crgonzalez/LaserCeeNC/README.md

# LaserCeeNC
Team 8 Senior Thesis Project code

Prototype Version 1 - Completed as of 2/10/16
