crgonzalez/LaserCeeNC/ChristiansEagleLibs/CC3200libs_alikian/Antenna.png

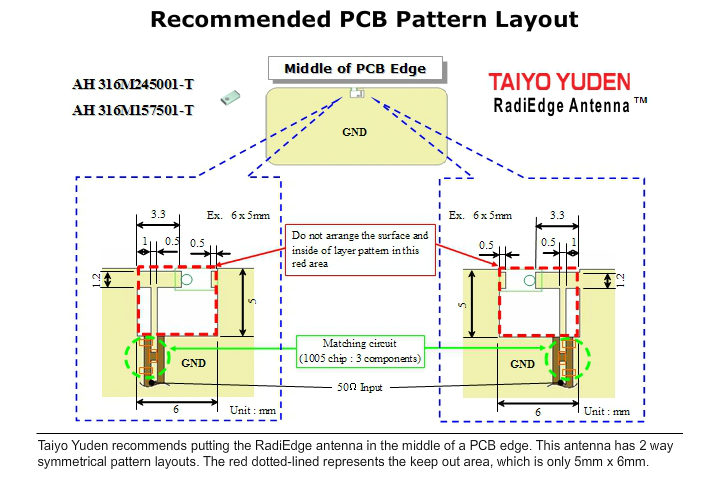
ChristiansEagleLibs/CC3200libs_alikian/Antenna.png
