crgonzalez/LaserCeeNC/ChristiansEagleLibs/CC3200libs_alikian/CC3200MOD_footprint.png

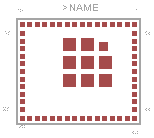
ChristiansEagleLibs/CC3200libs_alikian/CC3200MOD_footprint.png
