crgonzalez/LaserCeeNC/BOMs/LaserBoardBOM.xlsx

Reference | Digikey # | Description | Quantity | Unit Price | Extended Price
U$1 | 945-1610-5-ND | CONV DC/DC 1.5A 6.5-18VIN 5V | 1 | 10.73000 | $10.73
U$2 | 568-5461-1-ND | TXRX XLATING DUAL 3ST 6TSSOP | 1 | 0.45000 | $2.25
U$3, U$4 | 478-8115-1-ND | CAP TANT 10UF 6.3V 20% 0805 | 2 | 0.37000 | $0.74
U$5 | 360-2029-ND | SWITCH PUSHBUTTON SPDT 3A 125V | 1 | 13.85000 | $13.85
U$6 | 36-3527-ND | FUSE BLOCK CART 250V 6.3A PCB | 1 | 1.31000 | $1.31
U$7 | 296-2563-5-ND | IC 2.2A POWER DIST SWITCH 8-SOIC | 1 | 2.82000 | $2.82
U$8 | 609-3210-ND | CONN HEADER 6POS .100 STR 15AU | 1 | 0.40000 | $0.40
U$9 | 360-2188-ND | SENSOR TILT SW 30-60DEG 20MA TH | 1 | 6.39000 | $6.39
R1 | P510ADCT-ND | RES SMD 510 OHM 5% 1/2W 0805 | 1 | 0.12000 | $0.12
R2 | RMCF0805JT10K0CT-ND | RES SMD 10K OHM 5% 1/8W 0805 | 1 | 0.10000 | $0.10
R5 | 311-200ARCT-ND | RES SMD 200 OHM 5% 1/8W 0805 | 1 | 0.10000 | $0.10
R6 | 311-100KCRCT-ND | RES SMD 100K OHM 1% 1/8W 0805 | 1 | 0.10000 | $0.10
C1 | 478-1402-1-ND | CAP CER 0.33UF 16V X7R 0805 | 1 | 0.24000 | $0.24
C2 | 1276-1007-1-ND | CAP CER 0.1UF 50V Y5V 0805 | 1 | 0.10000 | $0.10
C3 | 1276-2412-1-ND | CAP CER 22UF 6.3V X5R 0805 | 1 | 0.25000 | $0.25
12V-PWR | CP-002AHPJCT-ND | CONN POWER JACK 2.1X5.5MM HI CUR | 1 | 1.89000 | $1.89
LSR_CONN, FAN_CONN | 455-2247-ND | CONN HEADER XH TOP 2POS 2.5MM | 2 | 0.15000 | $0.30
3.3V-REG | LMS8117AMP-3.3/NOPBCT-ND | IC REG LDO 3.3V 1A SOT223 | 1 | 1.11000 | $1.11
FUSE | 507-1253-ND | FUSE GLASS 5A 250VAC 5X20MM | 1 | 0.22000 | $0.44
