crgonzalez/LaserCeeNC/BOMs/MotorBoardBOM.xlsx

Reference | Digikey # | Description | Quantity | Unit Price | Extended Price
X_JST, Y_JST | 455-2243-ND | CONN HEADER XH SIDE 4POS 2.5MM | 2 | 0.27000 | $0.54
X_C10, Y_C10 | 399-3685-1-ND | CAP TANT 10UF 6.3V 20% 1206 | 2 | 0.35000 | $0.70
X_C8, Y_C8 | 399-3700-1-ND | CAP TANT 47UF 6.3V 20% 1206 | 2 | 0.73000 | $1.46
X_L6472, Y_L6472 | 497-14657-ND | IC MOTOR DRIVER SPI 36POWERSO | 2 | 7.69000 | $15.38
X_C5, Y_C5 | 399-1251-1-ND | CAP CER 0.22UF 50V X7R 1206 | 2 | 0.19000 | $0.38
X_C6, Y_C6 | 311-1174-1-ND | CAP CER 10000PF 50V X7R 1206 | 2 | 0.14000 | $0.28
X_BAV99, Y_BAV99 | 568-1625-1-ND | DIODE ARRAY GP 100V 150MA SOT323 | 2 | 0.21000 | $0.42
X_C1-X_C4, X_C7, X_C9, Y_C1-Y_C4, Y_C7, Y_C9 | 399-1249-1-ND | CAP CER 0.1UF 50V X7R 1206 | 12 | 0.07200 | $0.86
R1-R5 | CRS1206-FX-1002ELFCT-ND | RES SMD 10K OHM 1% 1/2W 1206 | 5 | 0.44000 | $2.20
X_BAC, Y_BAC | PCE3867CT-ND | CAP ALUM 100UF 20% 10V SMD | 2 | 0.43000 | $0.86
HEADER | A106656-ND | CONN RCPT VERT HV-100 6POS | 2 | 0.87000 | $1.74
