crgonzalez/LaserCeeNC/BOMs/OtherBOM.xlsx

Reference | Digikey # | Description | Quantity | Unit Price | Extended Price
StandOffs | 36-25501-ND | HEX STANDOFF M3 NYLON 10MM | 12 | 0.41200 | $4.95
Screws | 36-29341-ND | MACHINE SCREW PAN SLOTTED M3 | 4 | 0.20000 | $0.80
Hex Nut | 36-4688-ND | HEX NUT 0.217" NYLON M3 | 4 | 0.14000 | $0.56
