crgonzalez/LaserCeeNC/BOMs/uCBoardBOM.xlsx

Reference | Digikey # | Description | Quantity | Unit Price | Extended Price
U$1 | 296-42325-1-ND | IC MCU SIMPLELINK WI-FI MOD VQFN | 1 | 25.98 | $25.98
U$2 | 587-2200-1-ND | ANT BLUETOOTH W-LAN ZIGBEE WIMAX | 1 | 1.95 | $1.95
U$3 | P8070SCT-ND | SWITCH TACTILE SPST-NO 0.02A 15V | 1 | 0.29 | $0.29
U$4 | 5176837-4-SI-ND | CONN HDR BRKWAY 10POS R/A GOLD | 1 | 0.89 | $0.89
U$5, U$7 | A106656-ND | CONN RCPT VERT HV-100 6POS | 2 | 0.87 | $1.74
U$6 | 609-3210-ND | CONN HEADER 6POS .100 STR 15AU | 2 | 0.4 | $0.80
U$8 | A118117CT-ND | MICRO SD PUSH PUSH LOW PROFILE T | 1 | 4.28 | $4.28
C1 | 1276-3375-1-ND | CAP CER 220UF 6.3V X5R 1210 | 1 | 1.65 | $1.65
C2 | 1276-1766-1-ND | CAP CER 1PF 50V NP0 0805 | 1 | 0.1 | $0.10
C3 | 490-3340-1-ND | CAP CER 10UF 6.3V X5R 0805 | 2 | 0.15 | $0.30
R1 | RMCF0805JT2K70CT-ND | RES SMD 2.7K OHM 5% 1/8W 0805 | 1 | 0.1 | $0.10
R6 | 311-100CRCT-ND | RES SMD 100 OHM 1% 1/8W 0805 | 1 | 0.1 | $0.10
X1 | A122805-ND | CONN RCPT 4POS VERT T/H GOLD | 1 | 0.61 | $0.61
L1 | 490-6756-1-ND | FIXED IND 3.6NH 170MA 500 MOHM | 1 | 0.18 | $0.18
R2-R5 | 311-100KCRCT-ND | RES SMD 100K OHM 1% 1/8W 0805 | 4 | 0.021 | $0.21
