crgonzalez/LaserCeeNC/(list of files, cad)

Other CAD files:
Software/LaserCeenC/Release/optimizerAssistant/opt_for_speed__3/main.obj
Software/LaserCeenC/Release/optimizerAssistant/opt_for_speed__1/main.obj
Software/LaserCeenC/Release/optimizerAssistant/opt_for_speed__2/main.obj
Software/LaserCeenC/Release/optimizerAssistant/opt_for_speed__4/main.obj
Software/LaserCeenC/Release/optimizerAssistant/opt_for_speed__0/main.obj
Software/LaserCeenC/Release/optimizerAssistant/opt_for_speed__0/startup_ccs.obj
Software/LaserCeenC/Release/optimizerAssistant/opt_for_speed__1/smartconfig.obj
Software/LaserCeenC/Release/optimizerAssistant/opt_for_speed__2/gpio_if.obj
Software/LaserCeenC/Release/optimizerAssistant/opt_for_speed__4/gpio_if.obj
Software/LaserCeenC/Release/optimizerAssistant/opt_for_speed__0/uart_if.obj
Software/LaserCeenC/Release/optimizerAssistant/opt_for_speed__3/uart_if.obj
Software/LaserCeenC/Release/optimizerAssistant/opt_for_speed__0/gpio_if.obj
Software/LaserCeenC/Release/optimizerAssistant/opt_for_speed__1/startup_ccs.obj
Software/LaserCeenC/Release/optimizerAssistant/opt_for_speed__2/smartconfig.obj
Software/LaserCeenC/Release/optimizerAssistant/opt_for_speed__3/fileparse.obj
Software/LaserCeenC/Release/optimizerAssistant/opt_for_speed__4/uart_if.obj
Software/LaserCeenC/Release/optimizerAssistant/opt_for_speed__0/fileparse.obj
Software/LaserCeenC/Release/optimizerAssistant/opt_for_speed__1/uart_if.obj
Software/LaserCeenC/Release/optimizerAssistant/opt_for_speed__2/pinmux.obj
Software/LaserCeenC/Release/optimizerAssistant/opt_for_speed__3/gpio_if.obj
Software/LaserCeenC/Release/optimizerAssistant/opt_for_speed__4/pinmux.obj
Software/LaserCeenC/Release/optimizerAssistant/opt_for_speed__0/smartconfig.obj
Software/LaserCeenC/Release/optimizerAssistant/opt_for_speed__1/pinmux.obj
Software/LaserCeenC/Release/optimizerAssistant/opt_for_speed__2/uart_if.obj
Software/LaserCeenC/Release/optimizerAssistant/opt_for_speed__3/smartconfig.obj
Software/LaserCeenC/Release/optimizerAssistant/opt_for_speed__4/fileparse.obj
Software/LaserCeenC/Release/optimizerAssistant/opt_for_speed__1/fileparse.obj
Software/LaserCeenC/Release/optimizerAssistant/opt_for_speed__2/fileparse.obj
Software/LaserCeenC/Release/optimizerAssistant/opt_for_speed__3/startup_ccs.obj
Software/LaserCeenC/Release/optimizerAssistant/opt_for_speed__4/startup_ccs.obj
Software/LaserCeenC/Release/optimizerAssistant/opt_for_speed__0/pinmux.obj
Software/LaserCeenC/Release/optimizerAssistant/opt_for_speed__1/gpio_if.obj
Software/LaserCeenC/Release/optimizerAssistant/opt_for_speed__2/startup_ccs.obj
Software/LaserCeenC/Release/optimizerAssistant/opt_for_speed__3/pinmux.obj
Software/LaserCeenC/Release/optimizerAssistant/opt_for_speed__4/smartconfig.obj
