crgonzalez/LaserCeeNC/BlockDiagram/BlockDiagram.pdf

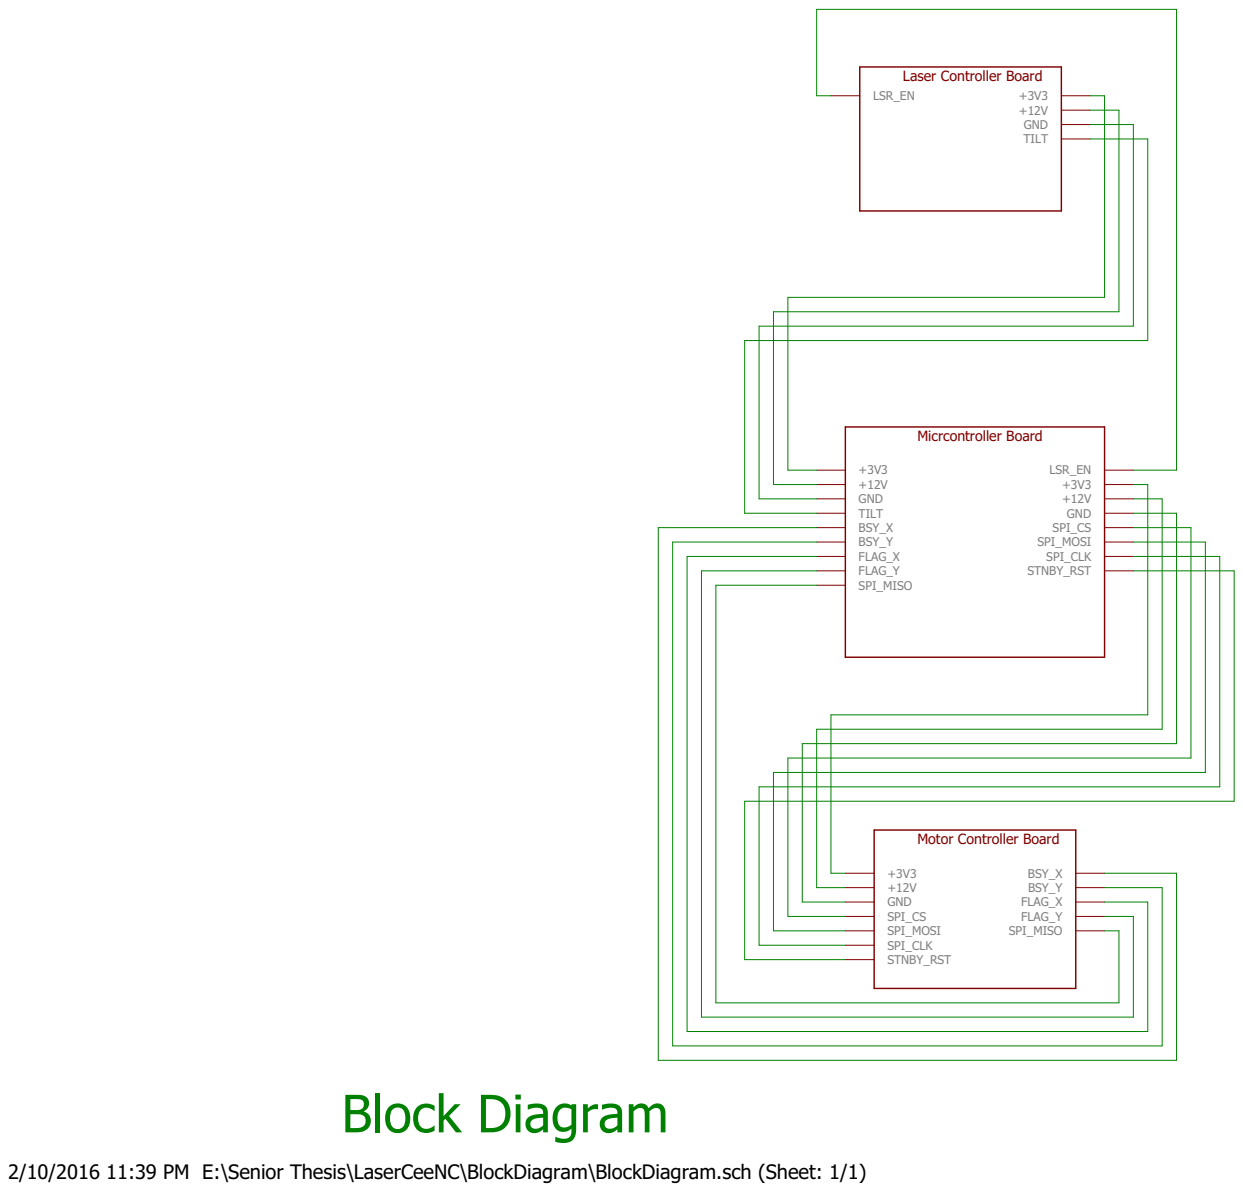
[picture p3: page 1]

2/10/2016 11:39 PM E:\Senior Thesis\LaserCeeNC\BlockDiagram\BlockDiagram.sch (Sheet: 1/1)
