crgonzalez/LaserCeeNC/LaserBoard/laserboard.pdf

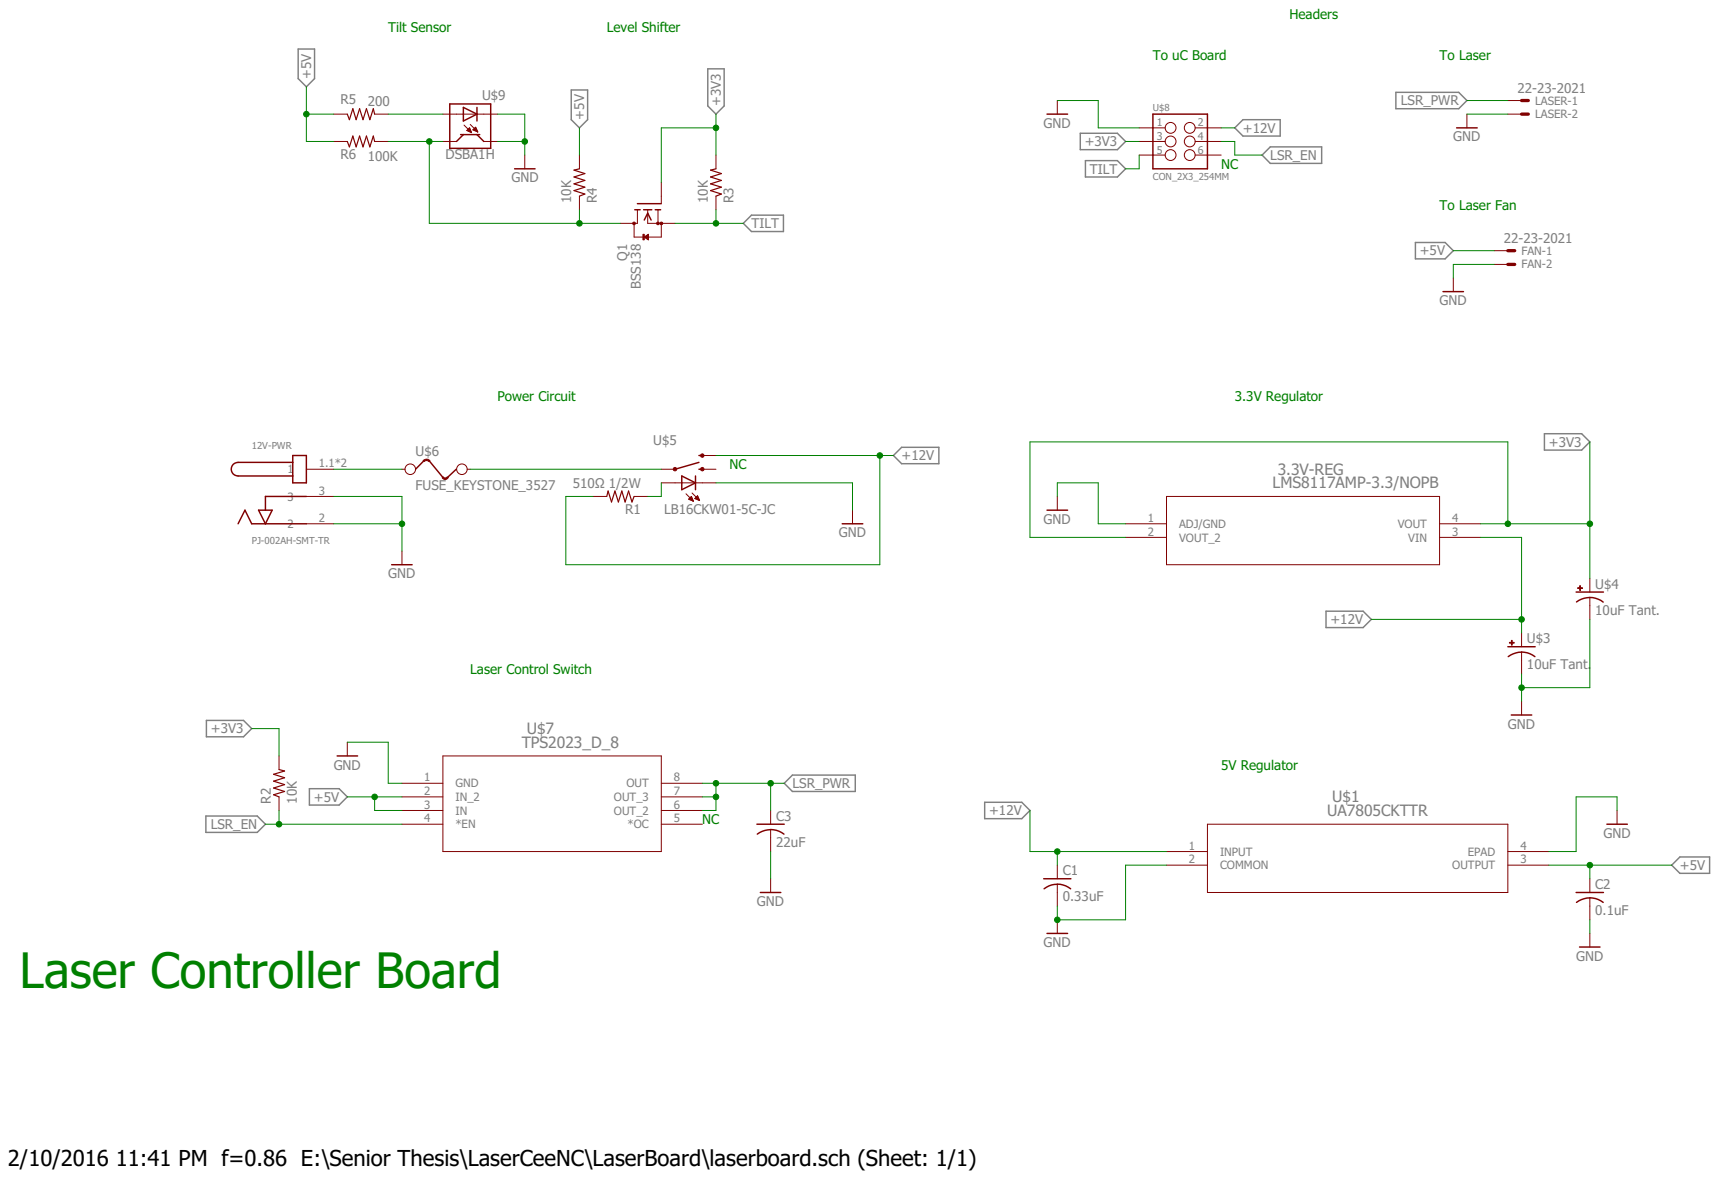
[picture p4: page 1]

2/10/2016 11:41 PM f=0.86 E:\Senior Thesis\LaserCeeNC\LaserBoard\laserboard.sch (Sheet: 1/1)
