crgonzalez/LaserCeeNC/uCBoard/uCBoard.pdf

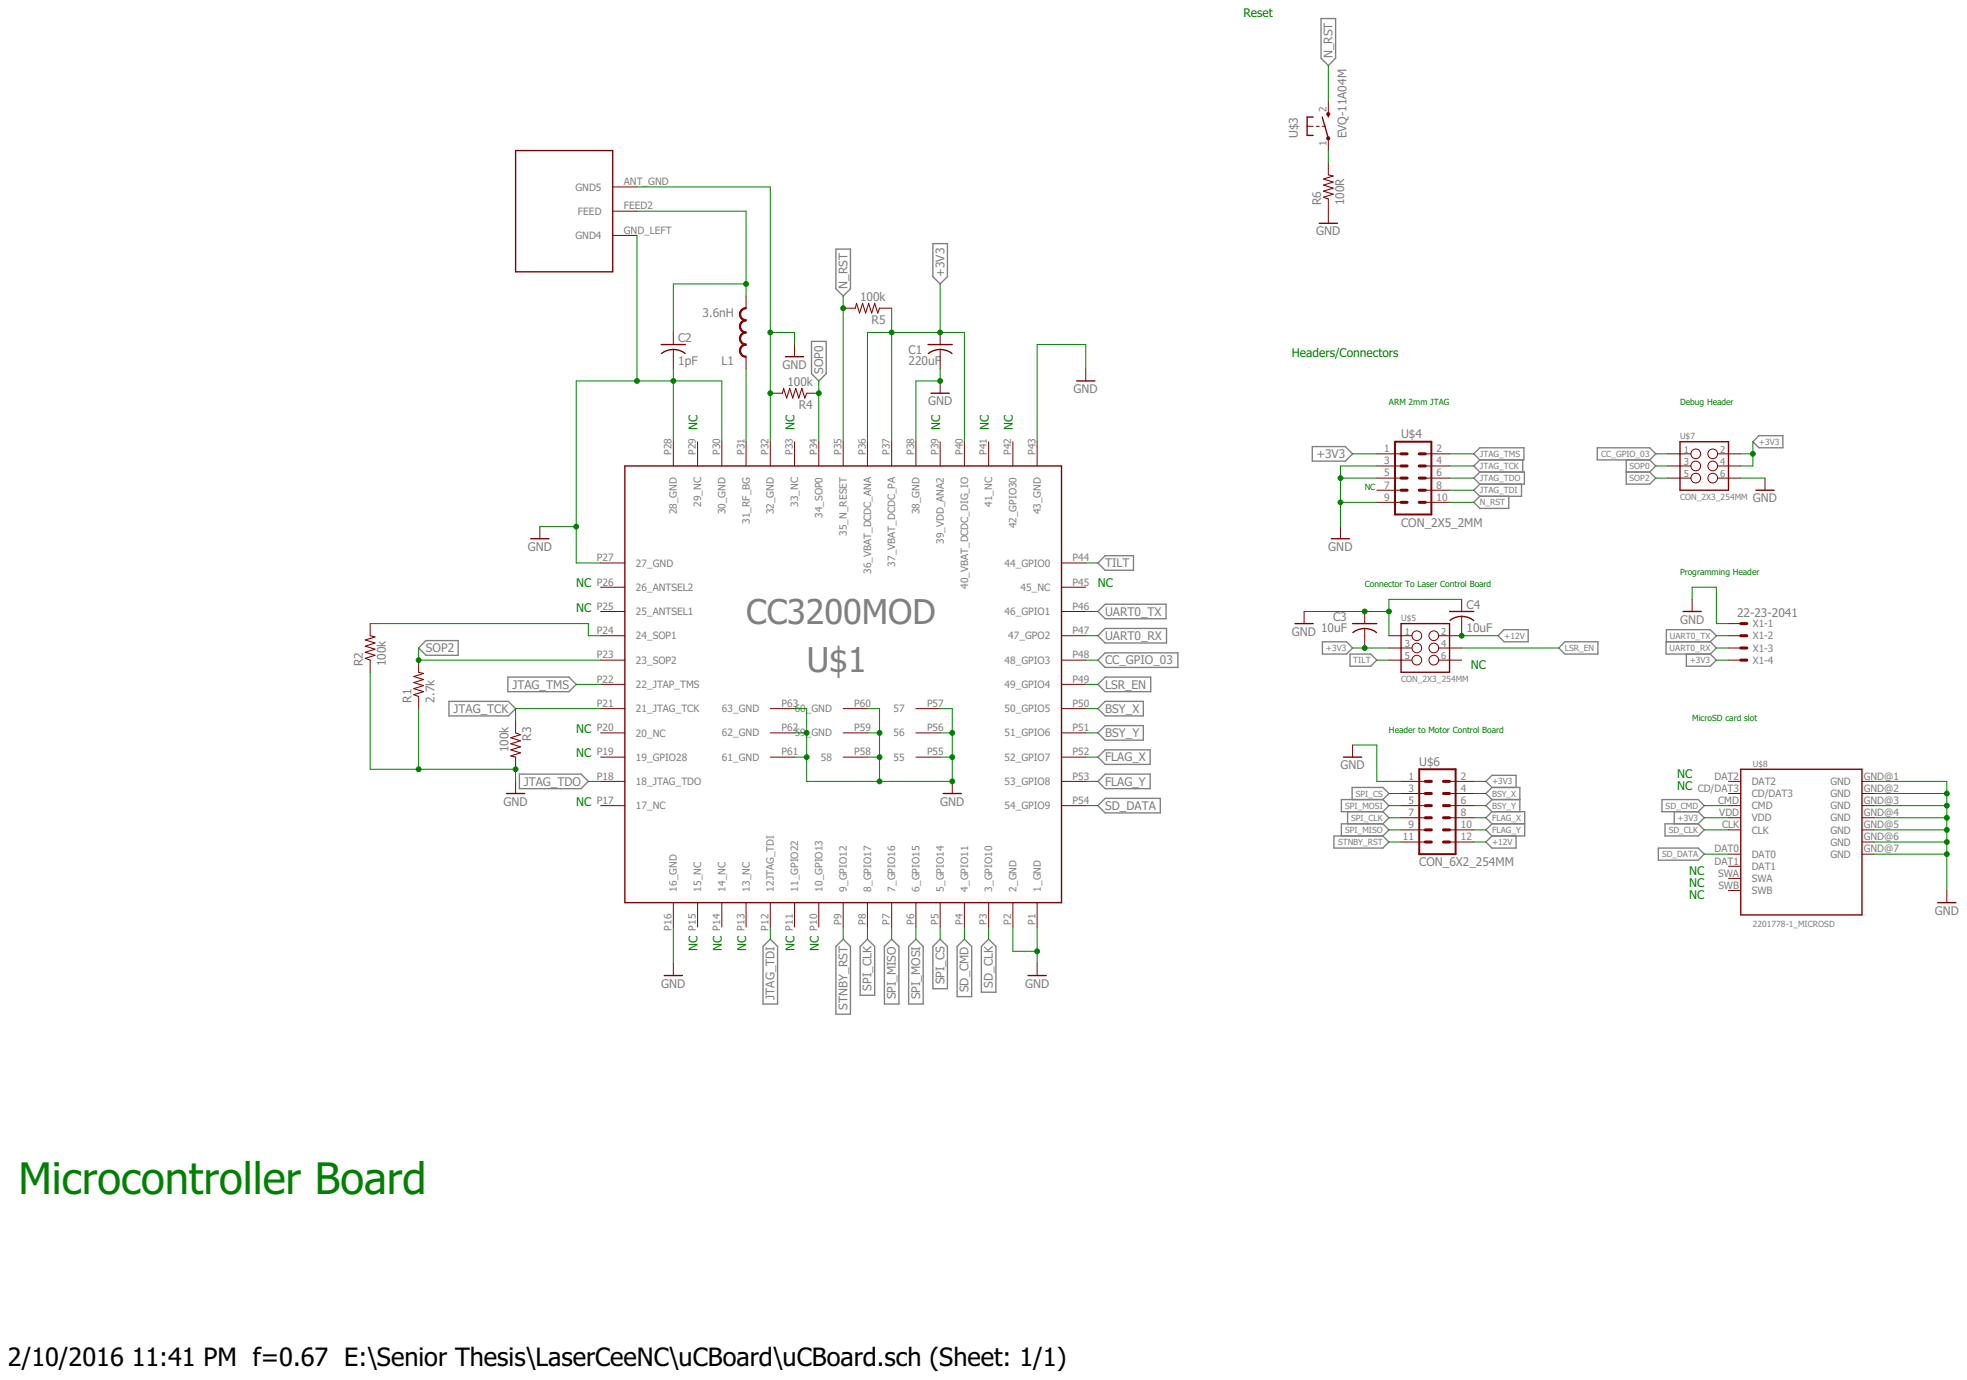
[picture p5: page 1]

Connector To Laser Control Board

Header to Motor Control Board NC

2/10/2016 11:41 PM f=0.67 E:\Senior Thesis\LaserCeeNC\uCBoard\uCBoard.sch (Sheet: 1/1)
