crgonzalez/LaserCeeNC/L6472Board/L6472V1/L6472V1.pdf

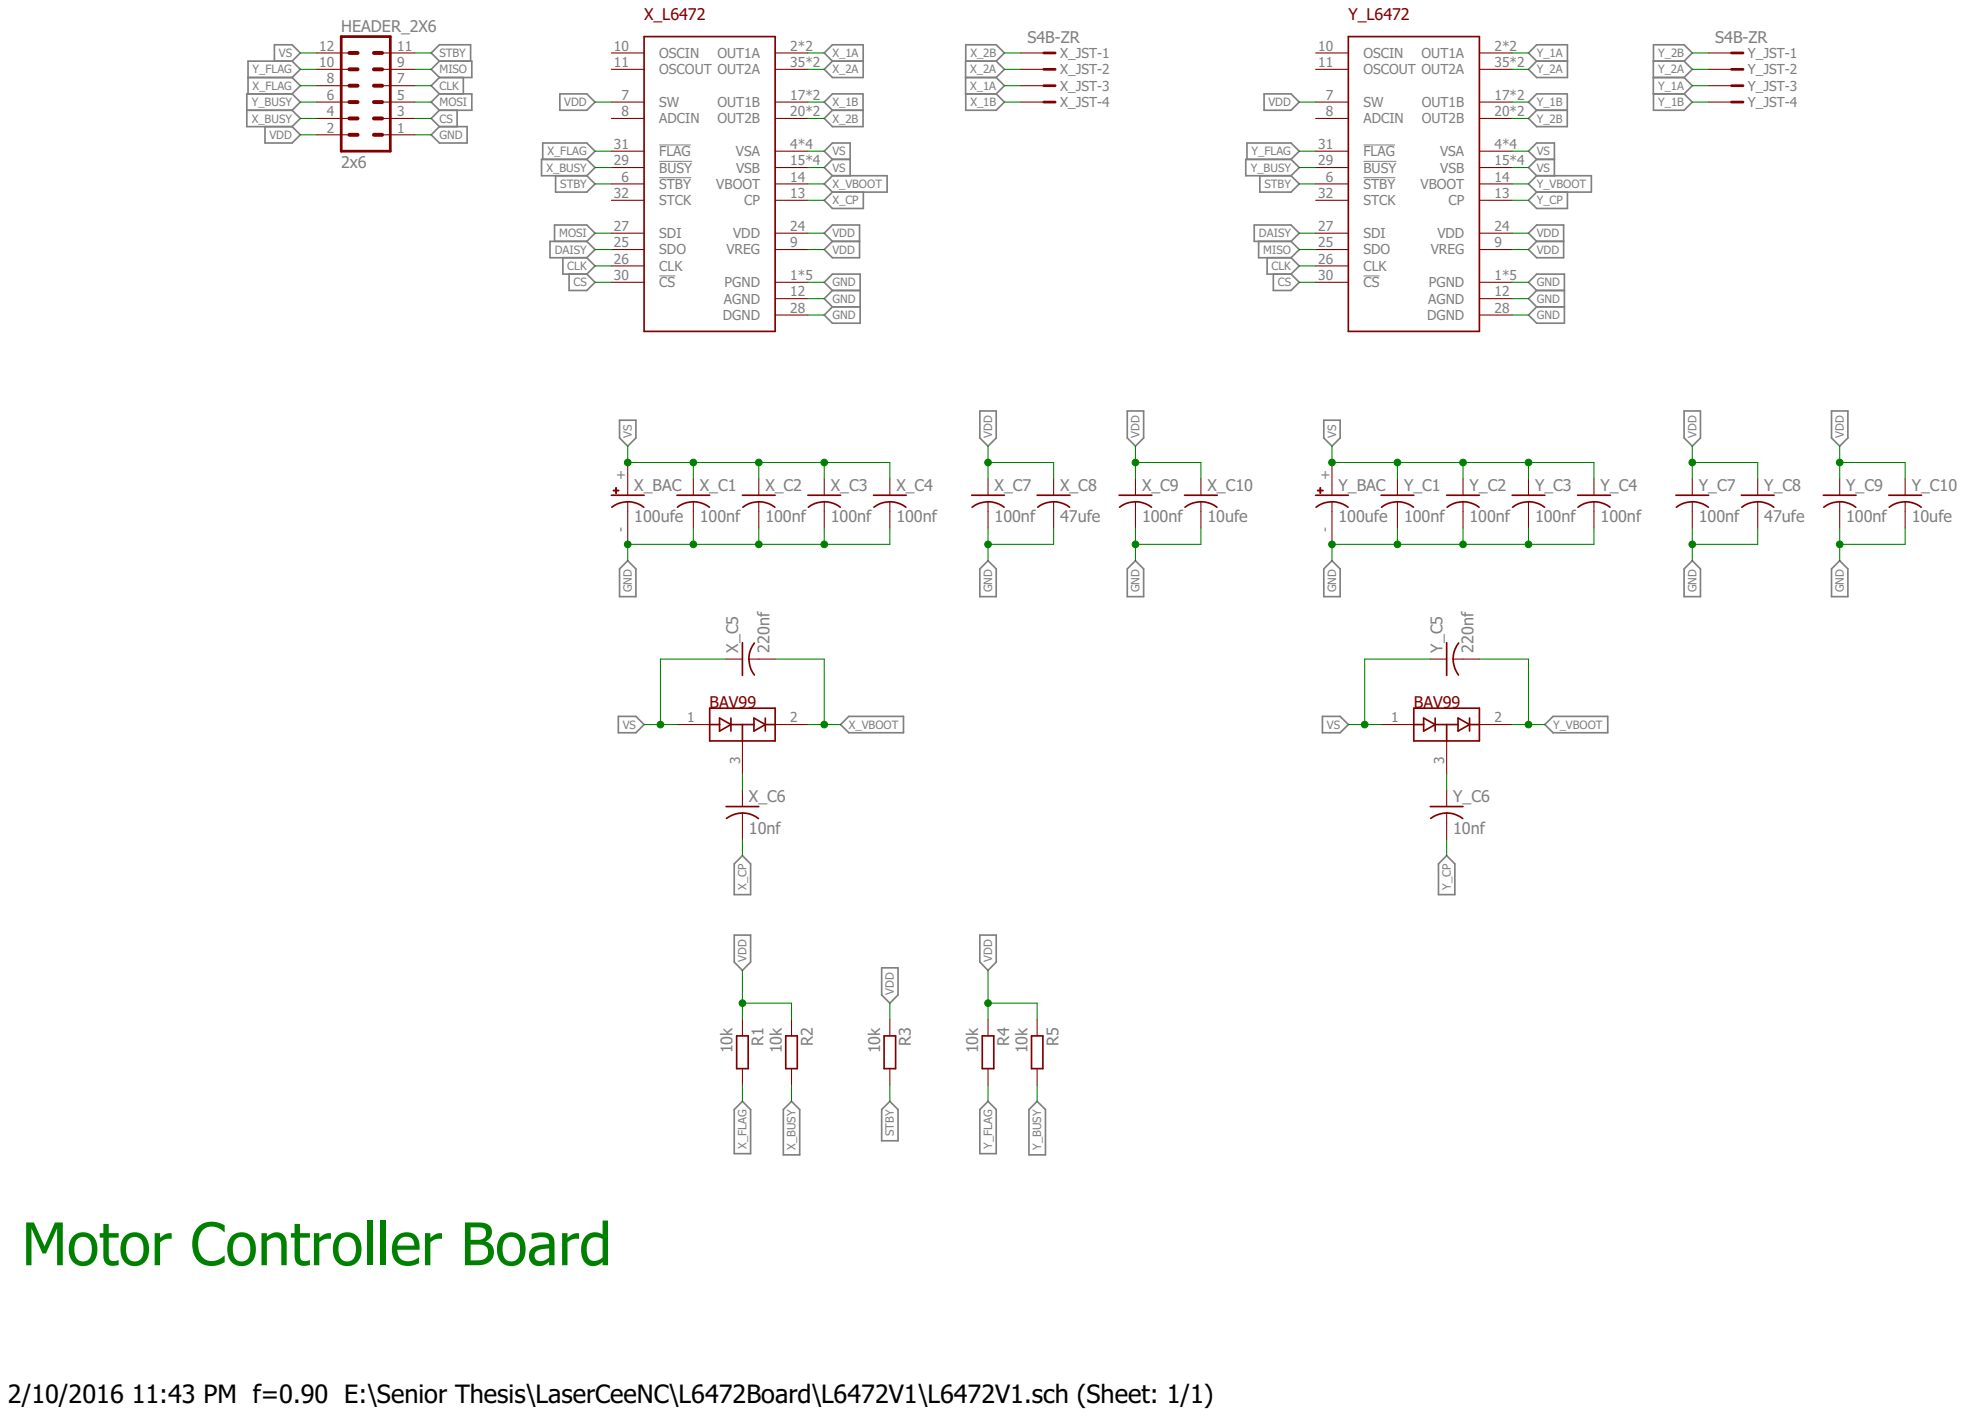
[picture p6: page 1]

2/10/2016 11:43 PM f=0.90 E:\Senior Thesis\LaserCeeNC\L6472Board\L6472V1\L6472V1.sch (Sheet: 1/1)
