crgonzalez/LaserCeeNC/LaserBoard/laserboard.brd

## EAGLE design LaserBoard/laserboard.brd (2016-03-13)

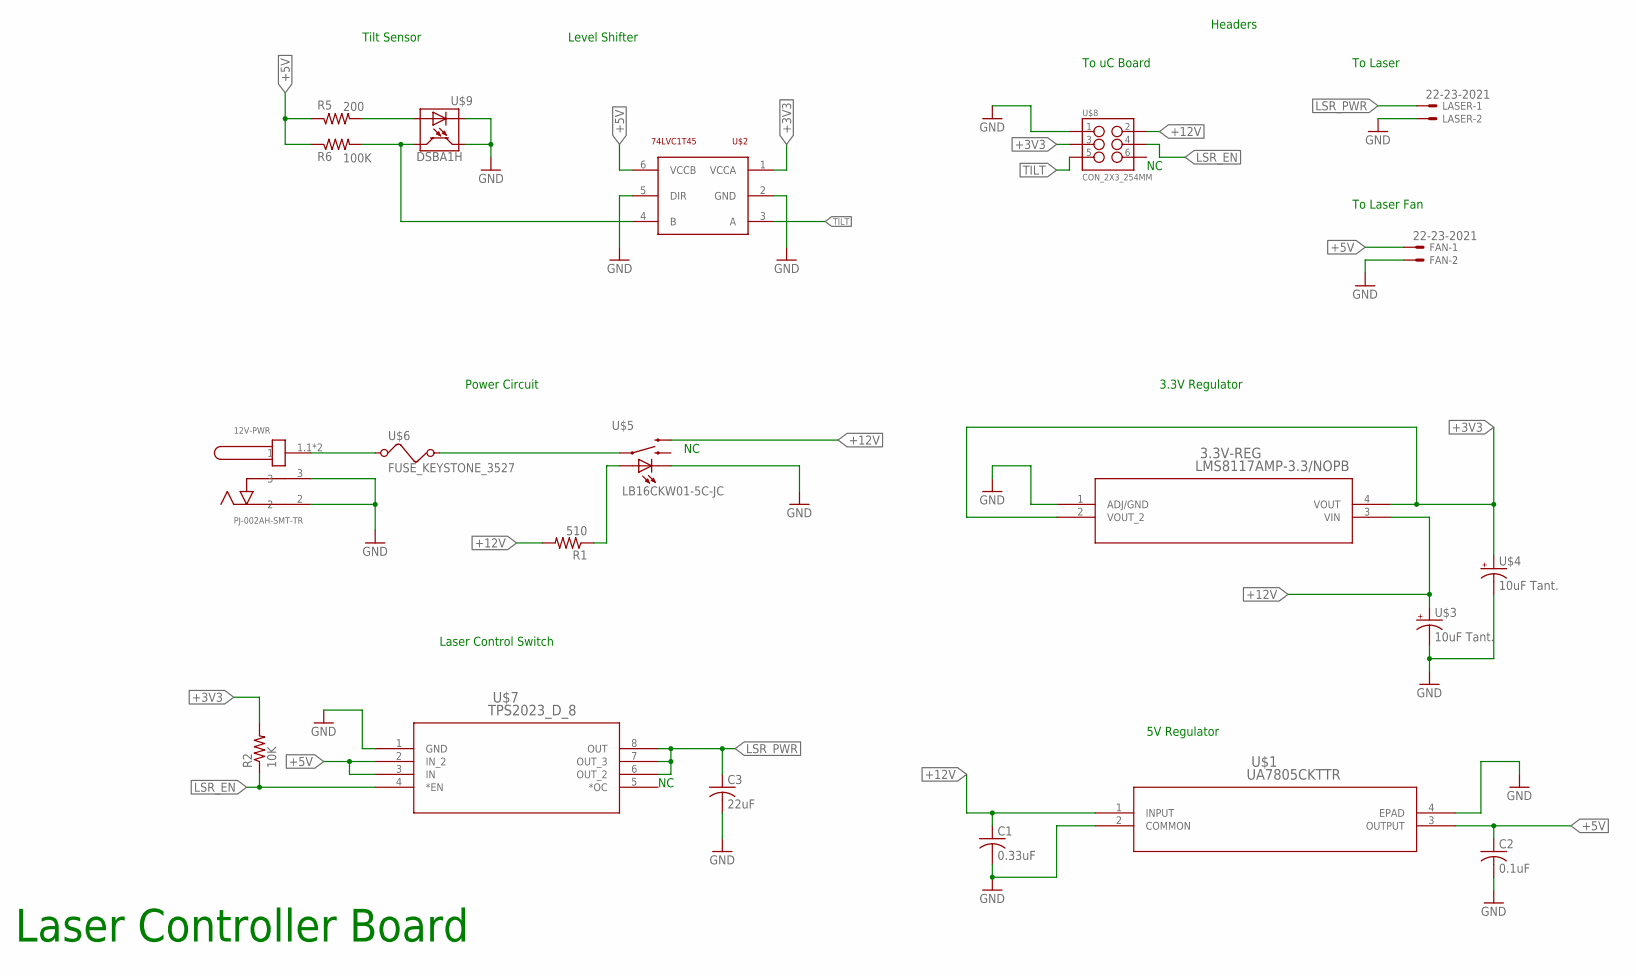
[picture p7: schematic laserboard.sch]

Parts:
3.3V-REG: LMS8117AMP-3.3/NOPB; MP04A
12V-PWR: PJ-002AH-SMT-TR; CUI_PJ-002AH-SMT-TR
C1: 0.33uF; C0805
C2: 0.1uF; C0805
C3: 22uF; C0805
FAN: 22-23-2021
LASER: 22-23-2021
R1: 510; R0805
R2: 10K; R0805
R5: 200; R0805
R6: 100K; R0805
U$1: UA7805CKTTR; KTT3_6P22X6P6
U$2: 74LVC1T45; SOT363
U$3, U$4: 10uF Tant.; C0805
U$5: LB16CKW01-5C-JC
U$6: FUSE_KEYSTONE_3527; KEYSTONE3527
U$7: TPS2023_D_8; D8
U$8: CON_2X3_254MM
U$9: DSBA1H

Connections:
+3V3: 3.3V-REG.2 (VOUT_2), 3.3V-REG.4 (VOUT), R2.2, U$2.1 (VCCA), U$4.+, U$8.3
+5V: C2.1, FAN.1, R5.1, R6.1, U$1.3 (OUTPUT), U$2.6 (VCCB), U$7.2 (IN_2), U$7.3 (IN)
+12V: 3.3V-REG.3 (VIN), C1.1, R1.2, U$1.1 (INPUT), U$3.+, U$5.2, U$8.2
GND: 3.3V-REG.1 (ADJ/GND), 12V-PWR.2, 12V-PWR.3, C1.2, C2.2, C3.2, FAN.2, LASER.2, U$1.2 (COMMON), U$1.4 (EPAD), U$2.2 (GND), U$2.5 (DIR), U$3.-, U$4.-, U$5.-, U$7.1 (GND), U$8.1, U$9.-, U$9.E
LSR_EN: R2.1, U$7.4 (*EN), U$8.4
LSR_PWR: C3.1, LASER.1, U$7.6 (OUT_2), U$7.7 (OUT_3), U$7.8 (OUT)
unnamed: R1.1, U$5.+
unnamed: 12V-PWR.1.1 (1), 12V-PWR.1.2 (1), U$6.P$1 (1)
unnamed: U$5.1, U$6.P$2 (2)
unnamed: R6.2, U$2.4 (B), U$9.C
unnamed: R5.2, U$9.+
TILT: U$2.3 (A), U$8.5

Notes on the sheet:
5V Regulator
3.3V Regulator
Power Circuit
Laser Control Switch
Headers
To Laser
To Laser Fan
To uC Board
Tilt Sensor
Level Shifter
Laser Controller Board

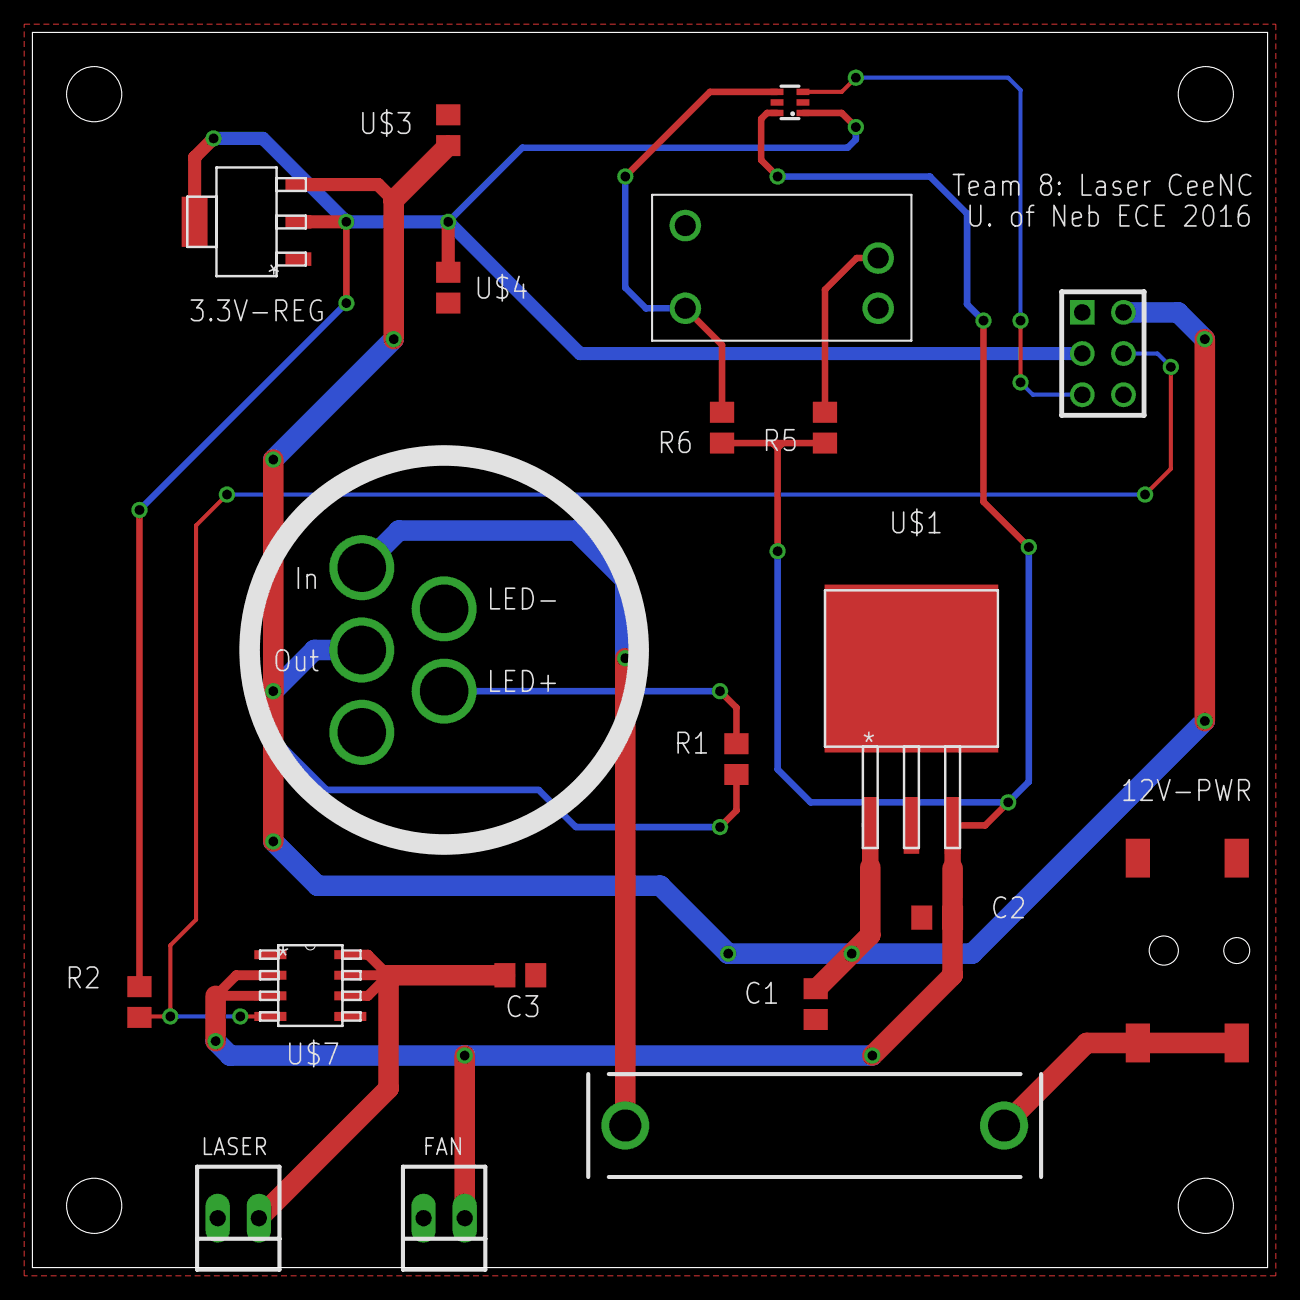
[picture p8: board laserboard.brd from above]

Board: 2 copper layers, 76.2 x 76.2 mm, 20 parts (0 on the bottom side), 12 nets.
