crgonzalez/LaserCeeNC/L6472Board/L6472V1/L6472V1.brd

## EAGLE design L6472Board/L6472V1/L6472V1.brd (2016-03-13)

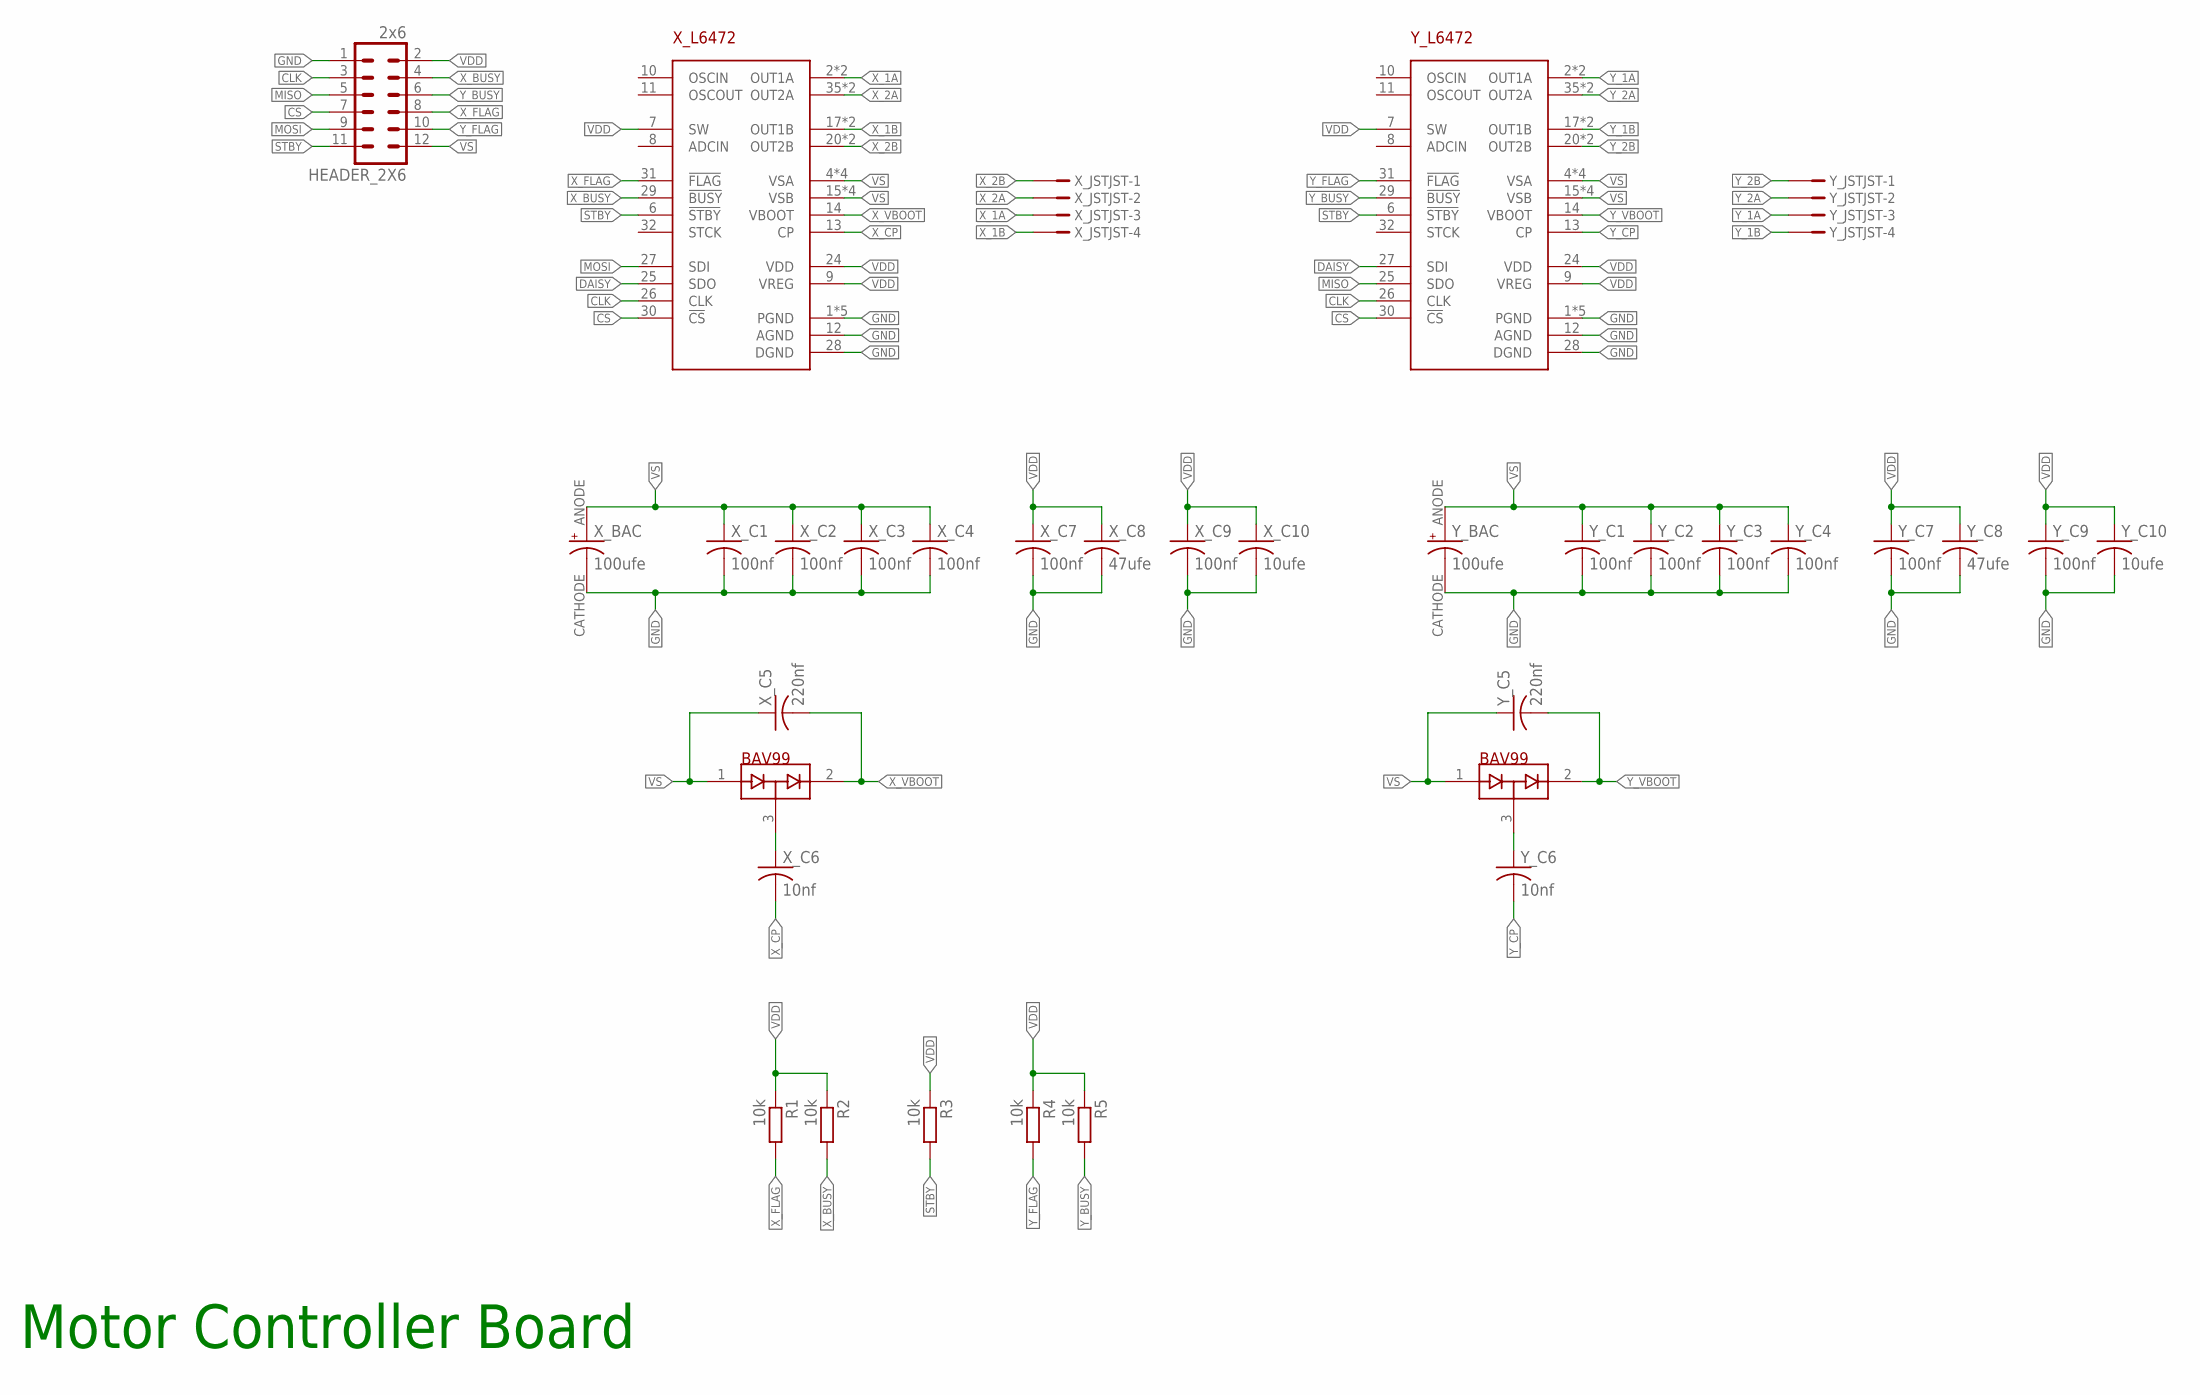
[picture p9: schematic L6472V1.sch]

Parts:
HEADER_2X6: 2x6; MA06-2
R1, R2, R3, R4, R5: 10k; M1206
X_BAC: 100ufe; EEE1AA101WR
X_BAV99: BAV99; SOT23_CPL
X_C1, X_C2, X_C3, X_C4, X_C7, X_C9: 100nf; C1206
X_C5: 220nf; C1206
X_C6: 10nf; C1206
X_C8: 47ufe; C1206
X_C10: 10ufe; C1206
X_JST: JST; JST-4
X_L6472: L6472; PSO36
Y_BAC: 100ufe; EEE1AA101WR
Y_BAV99: BAV99; SOT23_CPL
Y_C1, Y_C2, Y_C3, Y_C4, Y_C7, Y_C9: 100nf; C1206
Y_C5: 220nf; C1206
Y_C6: 10nf; C1206
Y_C8: 47ufe; C1206
Y_C10: 10ufe; C1206
Y_JST: JST; JST-4
Y_L6472: L6472; PSO36

Connections:
CLK: HEADER_2X6.3, X_L6472.26 (CLK), Y_L6472.26 (CLK)
CS: HEADER_2X6.7, X_L6472.30 (!CS), Y_L6472.30 (!CS)
DAISY: X_L6472.25 (SDO), Y_L6472.27 (SDI)
GND: HEADER_2X6.1, X_BAC.CATHODE (-), X_C1.2, X_C2.2, X_C3.2, X_C4.2, X_C7.2, X_C8.2, X_C9.2, X_C10.2, X_L6472.1 (PGND), X_L6472.12 (AGND), X_L6472.19 (PGND), X_L6472.28 (DGND), X_L6472.M@1 (PGND), X_L6472.M@2 (PGND), X_L6472.M@3 (PGND), Y_BAC.CATHODE (-), Y_C1.2, Y_C2.2, Y_C3.2, Y_C4.2, Y_C7.2, Y_C8.2, Y_C9.2, Y_C10.2, Y_L6472.1 (PGND), Y_L6472.12 (AGND), Y_L6472.19 (PGND), Y_L6472.28 (DGND), Y_L6472.M@1 (PGND), Y_L6472.M@2 (PGND), Y_L6472.M@3 (PGND)
MISO: HEADER_2X6.5, Y_L6472.25 (SDO)
MOSI: HEADER_2X6.9, X_L6472.27 (SDI)
STBY: HEADER_2X6.11, R3.2, X_L6472.6 (!STBY), Y_L6472.6 (!STBY)
VDD: HEADER_2X6.2, R1.1, R2.1, R3.1, R4.1, R5.1, X_C7.1, X_C8.1, X_C9.1, X_C10.1, X_L6472.7 (SW), X_L6472.9 (VREG), X_L6472.24 (VDD), Y_C7.1, Y_C8.1, Y_C9.1, Y_C10.1, Y_L6472.7 (SW), Y_L6472.9 (VREG), Y_L6472.24 (VDD)
VS: HEADER_2X6.12, X_BAC.ANODE (+), X_BAV99.1 (A1), X_C1.1, X_C2.1, X_C3.1, X_C4.1, X_C5.1, X_L6472.4 (VSA), X_L6472.5 (VSA), X_L6472.15 (VSB), X_L6472.16 (VSB), X_L6472.22 (VSB), X_L6472.23 (VSB), X_L6472.33 (VSA), X_L6472.34 (VSA), Y_BAC.ANODE (+), Y_BAV99.1 (A1), Y_C1.1, Y_C2.1, Y_C3.1, Y_C4.1, Y_C5.1, Y_L6472.4 (VSA), Y_L6472.5 (VSA), Y_L6472.15 (VSB), Y_L6472.16 (VSB), Y_L6472.22 (VSB), Y_L6472.23 (VSB), Y_L6472.33 (VSA), Y_L6472.34 (VSA)
X_1A: X_JST.P2, X_L6472.2 (OUT1A), X_L6472.3 (OUT1A)
X_1B: X_JST.P3, X_L6472.17 (OUT1B), X_L6472.18 (OUT1B)
X_2A: X_JST.P1, X_L6472.35 (OUT2A), X_L6472.36 (OUT2A)
X_2B: X_JST.P0, X_L6472.20 (OUT2B), X_L6472.21 (OUT2B)
X_BUSY: HEADER_2X6.4, R2.2, X_L6472.29 (!BUSY)
X_C1: Y_BAV99.3 (COM), Y_C6.1
X_C6: X_BAV99.3 (COM), X_C6.1
X_CP: X_C6.2, X_L6472.13 (CP)
X_FLAG: HEADER_2X6.8, R1.2, X_L6472.31 (!FLAG)
X_VBOOT: X_BAV99.2 (C2), X_C5.2, X_L6472.14 (VBOOT)
Y_1A: Y_JST.P2, Y_L6472.2 (OUT1A), Y_L6472.3 (OUT1A)
Y_1B: Y_JST.P3, Y_L6472.17 (OUT1B), Y_L6472.18 (OUT1B)
Y_2A: Y_JST.P1, Y_L6472.35 (OUT2A), Y_L6472.36 (OUT2A)
Y_2B: Y_JST.P0, Y_L6472.20 (OUT2B), Y_L6472.21 (OUT2B)
Y_BUSY: HEADER_2X6.6, R5.2, Y_L6472.29 (!BUSY)
Y_CP: Y_C6.2, Y_L6472.13 (CP)
Y_FLAG: HEADER_2X6.10, R4.2, Y_L6472.31 (!FLAG)
Y_VBOOT: Y_BAV99.2 (C2), Y_C5.2, Y_L6472.14 (VBOOT)

Notes on the sheet:
Motor Controller Board

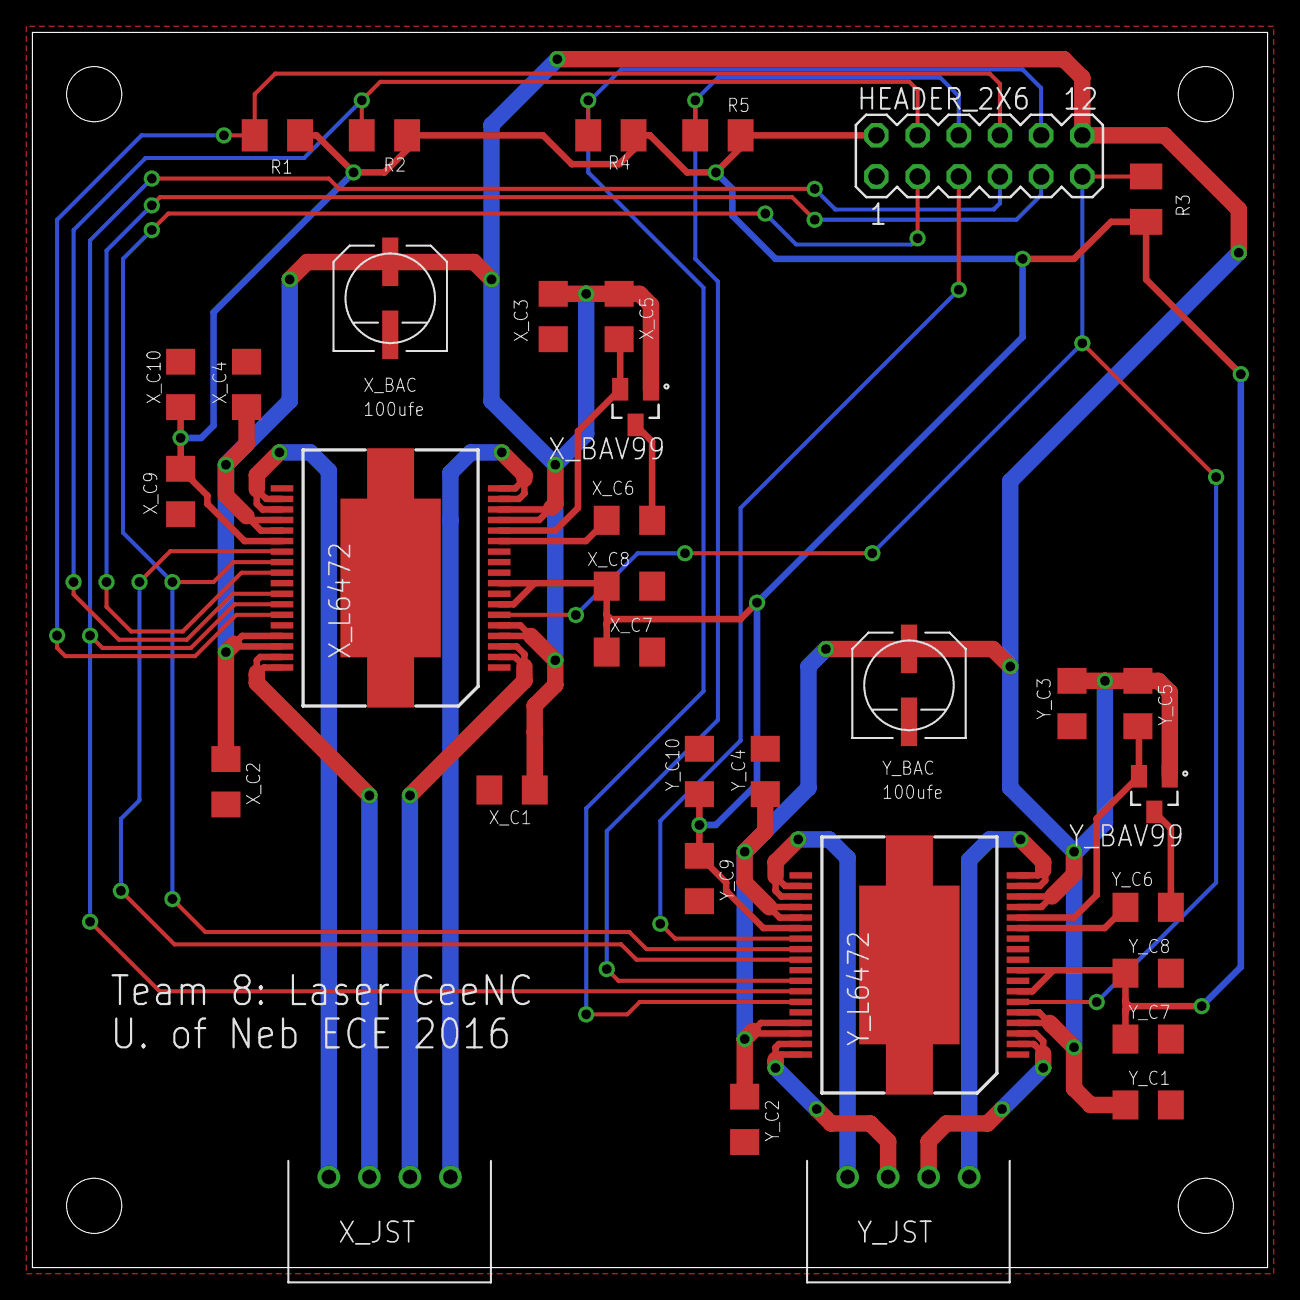
[picture p10: board L6472V1.brd from above]

Board: 2 copper layers, 76.2 x 76.2 mm, 34 parts (0 on the bottom side), 27 nets.
