crgonzalez/LaserCeeNC/uCBoard/uCBoard.brd

## EAGLE design uCBoard/uCBoard.brd (2016-02-29)

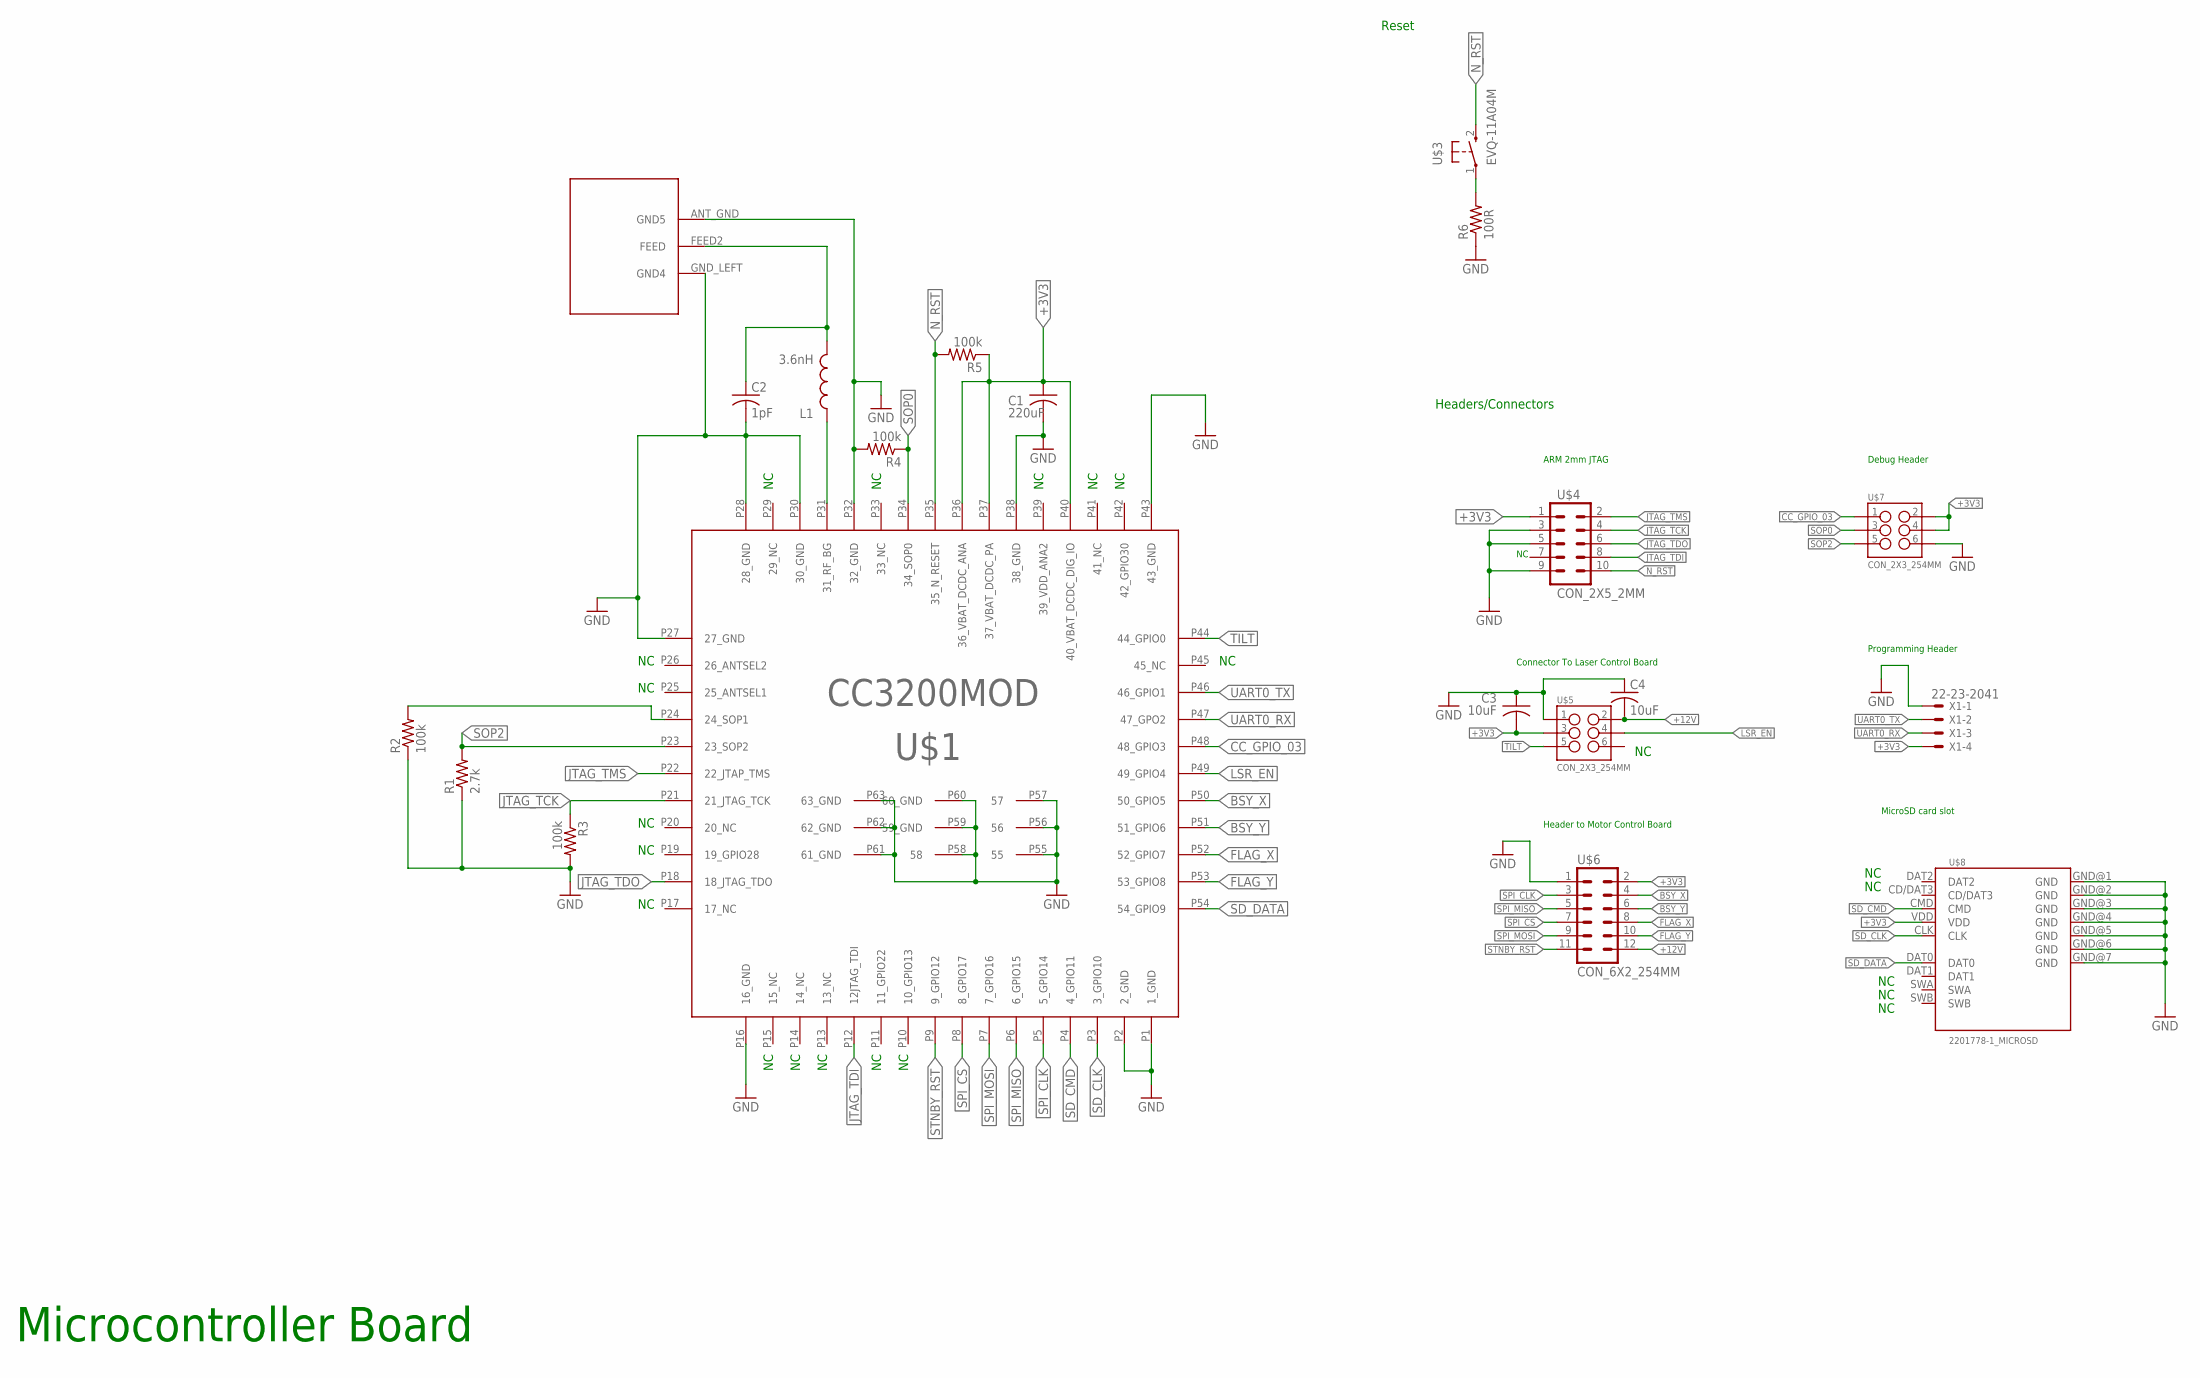
[picture p11: schematic uCBoard.sch]

Parts:
C1: 220uF; C1210
C2: 1pF; C0805
C3, C4: 10uF; C0805
L1: 3.6nH; C0402
R1: 2.7k; R0805
R2, R3, R4, R5: 100k; R0805
R6: 100R; R0805
U$1: CC3200; CC3200MOD
U$2: ANT
U$3: EVQ-11A04M; EVQ--11A04M
U$4: CON_2X5_2MM
U$5, U$7: CON_2X3_254MM
U$6: CON_6X2_254MM
U$8: 2201778-1_MICROSD; 2201778-1
X1: 22-23-2041

Connections:
+3V3: C1.1, C3.2, R5.1, U$1.P36 (36_VBAT_DCDC_ANA), U$1.P37 (37_VBAT_DCDC_PA), U$1.P40 (40_VBAT_DCDC_DIG_IO), U$4.1, U$5.3, U$6.2, U$7.2, U$7.4, U$8.VDD, X1.4
+12V: C4.2, U$5.2, U$6.12
BSY_X: U$1.P50 (50_GPIO5), U$6.4
BSY_Y: U$1.P51 (51_GPIO6), U$6.6
CC_GPIO_03: U$1.P48 (48_GPIO3), U$7.1
FLAG_X: U$1.P52 (52_GPIO7), U$6.8
FLAG_Y: U$1.P53 (53_GPIO8), U$6.10
GND: C1.2, C2.2, C3.1, C4.1, R1.1, R2.1, R3.2, R4.2, R6.1, U$1.P1 (1_GND), U$1.P2 (2_GND), U$1.P16 (16_GND), U$1.P27 (27_GND), U$1.P28 (28_GND), U$1.P30 (30_GND), U$1.P32 (32_GND), U$1.P38 (38_GND), U$1.P43 (43_GND), U$1.P55 (55), U$1.P56 (56), U$1.P57 (57), U$1.P58 (58), U$1.P59 (59_GND), U$1.P60 (60_GND), U$1.P61 (61_GND), U$1.P62 (62_GND), U$1.P63 (63_GND), U$2.ANT_GND (GND5), U$2.GND_LEFT (GND4), U$4.3, U$4.5, U$4.9, U$5.1, U$6.1, U$7.6, U$8.GND@1 (GND), U$8.GND@2 (GND), U$8.GND@3 (GND), U$8.GND@4 (GND), U$8.GND@5 (GND), U$8.GND@6 (GND), U$8.GND@7 (GND), X1.1
JTAG_TCK: R3.1, U$1.P21 (21_JTAG_TCK), U$4.4
JTAG_TDI: U$1.P12 (12JTAG_TDI), U$4.8
JTAG_TDO: U$1.P18 (18_JTAG_TDO), U$4.6
JTAG_TMS: U$1.P22 (22_JTAP_TMS), U$4.2
LSR_EN: U$1.P49 (49_GPIO4), U$5.4
unnamed: R6.2, U$3.1
unnamed: L1.1, U$1.P31 (31_RF_BG)
unnamed: R2.2, U$1.P24 (24_SOP1)
unnamed: C2.1, L1.2, U$2.FEED2 (FEED)
N_RST: R5.2, U$1.P35 (35_N_RESET), U$3.2, U$4.10
SD_CLK: U$1.P3 (3_GPIO10), U$8.CLK
SD_CMD: U$1.P4 (4_GPIO11), U$8.CMD
SD_DATA: U$1.P54 (54_GPIO9), U$8.DAT0
SOP0: R4.1, U$1.P34 (34_SOP0), U$7.3
SOP2: R1.2, U$1.P23 (23_SOP2), U$7.5
SPI_CLK: U$1.P5 (5_GPIO14), U$6.3
SPI_CS: U$1.P8 (8_GPIO17), U$6.7
SPI_MISO: U$1.P6 (6_GPIO15), U$6.5
SPI_MOSI: U$1.P7 (7_GPIO16), U$6.9
STNBY_RST: U$1.P9 (9_GPIO12), U$6.11
TILT: U$1.P44 (44_GPIO0), U$5.5
UART0_RX: U$1.P47 (47_GPO2), X1.3
UART0_TX: U$1.P46 (46_GPIO1), X1.2

Notes on the sheet:
Headers/Connectors
Reset
ARM 2mm JTAG
Connector To Laser Control Board
Header to Motor Control Board
Debug Header
Programming Header
MicroSD card slot
Microcontroller Board

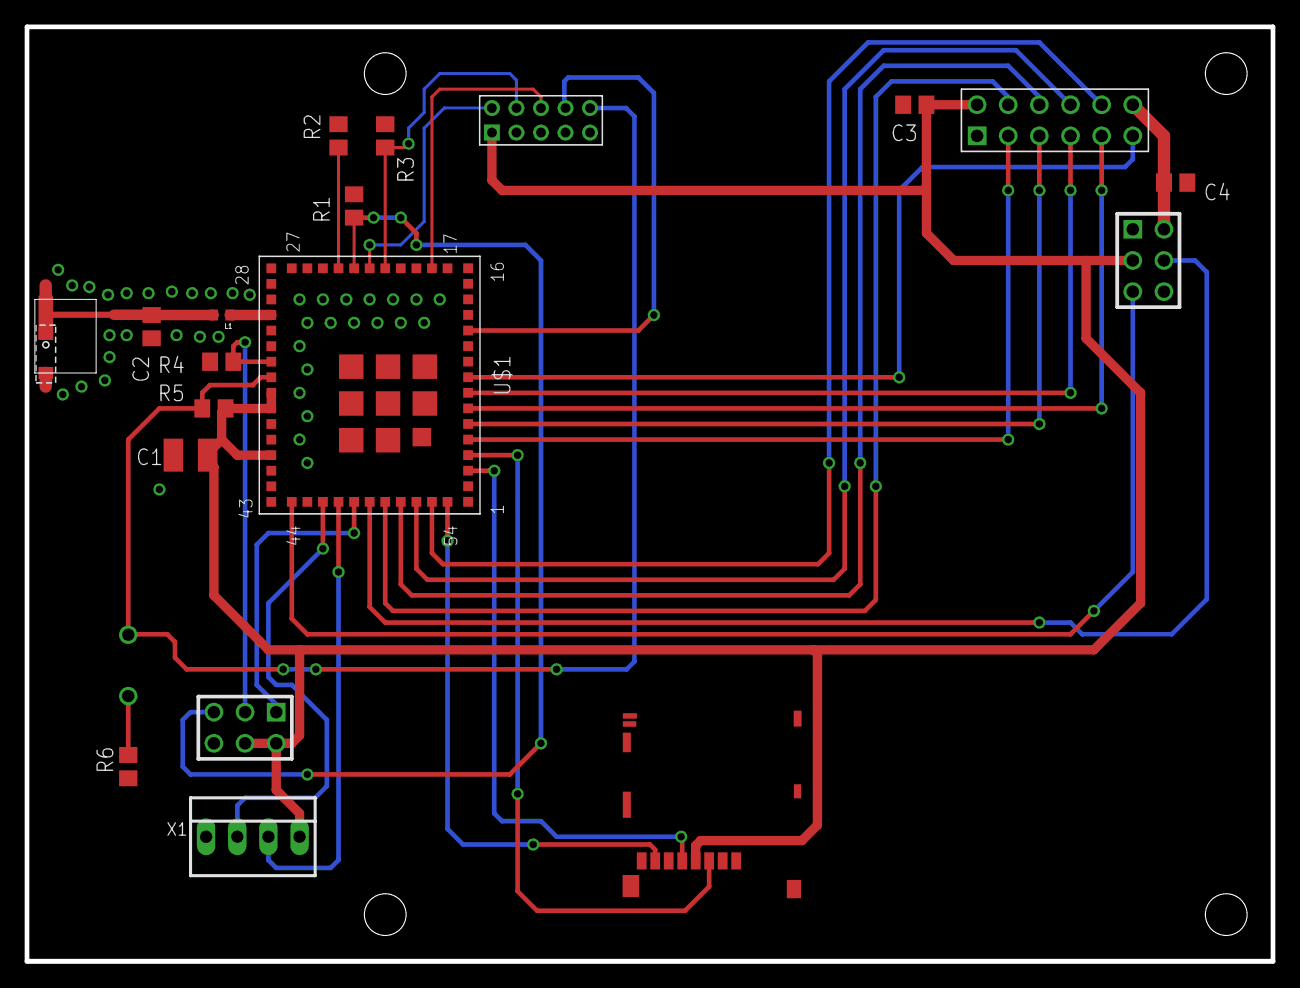
[picture p12: board uCBoard.brd from above]

Board: 2 copper layers, 101.6 x 76.2 mm, 20 parts (0 on the bottom side), 31 nets.
