crgonzalez/LaserCeeNC/Software/LaserCeenC/fileparse.h

/*********************************************
 *
 * fileparse.h
 *
 *
 * Created on 4/1/2016  9:37 PM
 *
 * Author: Zachary L. Mitchell
 *
 *
 *
 *********************************************/

#ifndef FILEPARSE_H_
#define FILEPARSE_H_

int fileparse(char* file);
void gcommand(char* line);
void mcommand(char* line);

#endif
