crgonzalez/LaserCeeNC/spi_demo/gcode.c

/*
 * gcode.c
 *
 *  Created on: Apr 1, 2016
 *      Author: Isaac
 */

#include <math.h>

#include "gcode.h"
#include "L6472.h"
#include "LaserBoard.h"

#include "hw_types.h"
#include "hw_memmap.h"
#include "spi.h"
#include "rom_map.h"
#include "gpio.h"
#include "pin.h"
#include "prcm.h"
#include "uart_if.h"

/****************************************************************************
 * GLOBAL VARIABLES
 ****************************************************************************/
// G0 speed
static float f_g0 = 3;
// G1 speed
static float f_g1 = 3;
// M3 and M5 laser intensity
static uint8_t s_m3_m5;


typedef enum RADIUS_SIDE { LEFT, RIGHT, ON_LINE } rad_side_t;


/****************************************************************************
 * Private function prototypes
 ****************************************************************************/
// Find the distance between (x,y) and (i,j)
float distance_xyij( float x, float y, float i, float j );

// Find the side of a radius a line falls
rad_side_t side_of_rad( float xc, float yc, float xs, float ys, float xf, float yf );


/****************************************************************************
 * G0: Rapid positioning
 ****************************************************************************/
// Set f paramter
void G0_f( float f ) {
	Report( "\r\nG0 F%f", f );
	//f_g0 = f;
}

// Execute move to position (x,y)
void G0_xy( float x, float y ) {
	Report( "\r\nG0 X%f Y%f", x, y );
	// Configure speed
	x_set_max_speed( f_g0 );
	y_set_max_speed( f_g0 );

	// Execute move
	move_coord( x, y );
}


/****************************************************************************
 * G1: Linear interpolation
 ****************************************************************************/
// Set f (speed) paramter
void G1_f( float f ) {
	Report( "\r\nG1 F%f", f );
	//f_g1 = f;
}

// Execute move to position (x,y)
void G1_xy( float x, float y ) {
	Report( "\r\nG1 X%f Y%f", x, y );
	// Configure speed
	x_set_max_speed( f_g1 );
	y_set_max_speed( f_g1 );

	// Execute move
	move_coord( x, y );
}


/****************************************************************************
 * G2: Clockwise arc
 ****************************************************************************/
// Move to (x,y) while remaining equidistant from (i,j)+starting point
void G2_xyij( float x, float y, float i, float j ) {
	float x_cur = x_get_position();
	float y_cur = y_get_position();

	// Add center to i and j
	i += x_cur;
	j += y_cur;

	//Report( "\r\nStart X%f Y%f", x_cur, y_cur );

	float x_next;
	float y_next;

	const float radius = distance_xyij( x, y, i, j );
	float x_mov = 0.2;

	const float dist_threshold = .6;

	float cur_dist = distance_xyij( x, y, x_cur, y_cur );

	int same_flag = 0;
	if( x == x_cur && y == y_cur ) {
		same_flag = 1;
	}

	while( cur_dist > dist_threshold || side_of_rad( i, j, x_cur, y_cur, x, y ) == LEFT || same_flag == 1 ) {
		//Report( "\r\nx_cur %f y_cur %f", x_cur, y_cur );
		if( y_cur < j ) {
			//Report( "A" );
			x_next = x_cur - x_mov;
			if( x_next < i - radius ) {
				x_next = i - radius;
				y_next = 0;
			} else {
				y_next = -sqrt( radius*radius - (x_next - i)*(x_next - i) );
			}
		} else if( y_cur == j && x_cur > i ) {
			//Report( "B" );
			x_next = x_cur - x_mov;
			y_next = -sqrt( radius*radius - (x_next - i)*(x_next - i) );

		} else if( y_cur == j && x_cur < i ) {
			//Report( "C" );
			x_next = x_cur + x_mov;
			y_next = sqrt( radius*radius - (x_next - i)*(x_next - i) );

		} else {
			//Report( "D" );
			x_next = x_cur + x_mov;
			if( x_next > i + radius ) {
				x_next = i + radius;
				y_next = 0;
			} else {
				y_next = sqrt( radius*radius - (x_next - i)*(x_next - i) );
			}
		}

		//x_next += x_cur;
		y_next += j;

		if( distance_xyij( x_cur, y_cur, x_next, y_next ) >= distance_xyij( x_cur, y_cur, x, y )
				&& side_of_rad( i, j, x_cur, y_cur, x, y ) == RIGHT ) {
			break;
		}

		//Report( "\r\nX%f Y%f", x_next, y_next );
		move_coord( x_next, y_next );
		x_cur = x_get_position();
		y_cur = y_get_position();
		//x_cur = x_next;
		//y_cur = y_next;
		cur_dist = distance_xyij( x, y, x_cur, y_cur );

		same_flag = 0;
	}

	move_coord( x, y );

}


/****************************************************************************
 * G3: Counterclockwise arc
 ****************************************************************************/
// Move to (x,y) while remaining equidistant form (i,j)+starting point
void G3_xyij( float x, float y, float i, float j ) {
	float x_cur = x_get_position();
	float y_cur = y_get_position();

	// Add starting point to i and j
	i += x_cur;
	j += y_cur;

	//Report( "\r\nStart X%f Y%f", x_cur, y_cur );

	float x_next;
	float y_next;

	const float radius = distance_xyij( x, y, i, j );
	float x_mov = 0.2;

	const float dist_threshold = 0.6;

	float cur_dist = distance_xyij( x, y, x_cur, y_cur );

	int same_flag = 0;
	if( x == x_cur && y == y_cur ) {
		same_flag = 1;
	}

	while( cur_dist > dist_threshold || side_of_rad( i, j, x_cur, y_cur, x, y ) == RIGHT || same_flag == 1 ) {
		//Report( "\r\nx_cur %f y_cur %f", x_cur, y_cur );
		if( y_cur < j ) {
			//Report( "A" );
			x_next = x_cur + x_mov;
			if( x_next > i + radius ) {
				x_next = i + radius;
				y_next = 0;
			} else {
				y_next = -sqrt( radius*radius - (x_next - i)*(x_next - i) );
			}
		} else if( y_cur == j && x_cur > i ) {
			//Report( "B" );
			x_next = x_cur - x_mov;
			y_next = sqrt( radius*radius - (x_next - i)*(x_next - i) );

		} else if( y_cur == j && x_cur < i ) {
			//Report( "C" );
			x_next = x_cur + x_mov;
			y_next = -sqrt( radius*radius - (x_next - i)*(x_next - i) );

		} else {
			//Report( "D" );
			x_next = x_cur - x_mov;
			if( x_next < i - radius ) {
				x_next = i - radius;
				y_next = 0;
			} else {
				y_next = sqrt( radius*radius - (x_next - i)*(x_next - i) );
			}
		}

		//x_next += x_cur;
		y_next += j;

		Report("\r\nD2next %f D2Fin %f", distance_xyij( x_cur, y_cur, x_next, y_next ), distance_xyij( x_cur, y_cur, x, y ));
		if( distance_xyij( x_cur, y_cur, x_next, y_next ) >= distance_xyij( x_cur, y_cur, x, y )
				&& side_of_rad( i, j, x_cur, y_cur, x, y ) == LEFT ) {
			break;
		}

		//Report( "\r\nX%f Y%f", x_next, y_next );
		move_coord( x_next, y_next );
		x_cur = x_get_position();
		y_cur = y_get_position();
		//x_cur = x_next;
		//y_cur = y_next;
		cur_dist = distance_xyij( x, y, x_cur, y_cur );

		same_flag = 0;
	}

	move_coord( x, y );

}


/****************************************************************************
 * G4: Dwell
 ****************************************************************************/
//
void G4_p( float p ) {
	Report( "\r\nG4 P%f", p );
	// do nothing right now
}


/****************************************************************************
 * G21: MMs as units
 ****************************************************************************/
// Program in MMs
void G21( void ) {
	Report( "\r\nG21" );
	//lol does nothing
}


/****************************************************************************
 * G90: Absolute position
 ****************************************************************************/
// Set origin to current location
void G90( void ) {
	Report( "\r\nG90" );
	// Lock in zero position on x and y
	x_set_origin();
	y_set_origin();
}


/****************************************************************************
 * M3: Laser on
 ****************************************************************************/
// Turn on laser
void M3_s( uint16_t s ) {
	Report( "\r\nM3 S%d", s );
	// Set intensity (this variable does nothing)
	s_m3_m5 = s;

	laser_on();
}


/****************************************************************************
 * M5: Laser off
 ****************************************************************************/
// Turn off laser
void M5_s( uint16_t s ) {
	Report( "\r\nM5 S%d", s );
	// Set intensity (this variable does nothing)
	s_m3_m5 = s;

	laser_off();
}

/****************************************************************************
 * M18: Disable stepper motors
 ****************************************************************************/
// Release x and y motor bridges
void M18( void ) {
	Report( "\r\nM18" );
	x_release_bridge();
	y_release_bridge();
}


/****************************************************************************
 * Private function definitions
 ****************************************************************************/
// Find the distance between (x,y) and (i,j)
float distance_xyij( float x, float y, float i, float j ) {
	return sqrt( (x - i)*(x - i) + (y - j)*(y - j) );
}


// Find the side of a radius a line falls
rad_side_t side_of_rad( float xc, float yc, float xs, float ys, float xf, float yf ) {
	float side = ( (xs - xc)*(yf - yc) - (ys - yc)*(xf - xc) );

	if( side > 0 ) {
		return LEFT;
	} else if( side < 0 ) {
		return RIGHT;
	} else {
		return ON_LINE;
	}
}
