crgonzalez/LaserCeeNC/spi_demo/LaserBoard.h

/*
 * LaserBoard.h
 *
 *  Created on: Mar 16, 2016
 *      Author: Isaac
 */

#ifndef LASERBOARD_H_
#define LASERBOARD_H_

void laser_init( void );

void laser_off( void );

void laser_on( void );

#endif /* LASERBOARD_H_ */
