crgonzalez/LaserCeeNC/(commit log)

2016-01-23 Adding Motor Controller Board Eagle Project
    This adds the Eagle files for the Motor Controller Board.
    L6742LIB.lbr holds several footprints and custom components needed by
    the project.
    L6472V1.brd is the board file for laying out the PCB.
    L6472V1.sch is the schematic file for the board.
    eagle.epf is a file created by Eagle. Not sure what it does but it seems
    important...
    [L6472V1.brd, L6472V1.sch]
2016-01-23 Completed Routing of PCB
    The layout of the L6472 PCB was completed.
    [L6472V1.brd]
2016-01-25 Initial Schematic Commit
    [laserboard.sch, uCBoard.sch]
2016-01-30 Fixing custom lib silkscreens
2016-01-31 Layed out uC Board, not yet routed
    [uCBoard.brd, uCBoard.sch]
2016-01-31 Routed majority of uC Board
    [uCBoard.brd]
2016-02-01 Added GND plane and fixed the SD card footprint
    [uCBoard.brd, uCBoard.sch]
2016-02-02 Preliminary Component Placement
    All of the components have been placed onto the 3x3 outline in their
    general location.
    [laserboard.brd, laserboard.sch]
2016-02-02 Utilized Christian's Updated Library
    Reloaded ChristiansCustom library to make use of the updated components
    submitted by Christian.
    [laserboard.brd, laserboard.sch]
2016-02-03 Completed Layout of the Laser PCB
    This is the completed layout of the Laser PCB. All components and traces
    have been laid. The final DRC before manufacturing has not been
    performed.
    [laserboard.brd, laserboard.sch]
2016-02-03 Finished the uCBoard, added custom CAM processor, and created Gerber files
    [uCBoard.GBL, uCBoard.GBO, uCBoard.GBS, uCBoard.GKO, uCBoard.GTL, uCBoard.GTO, uCBoard.GTP, uCBoard.GTS]
2016-02-07 Final Laser Board Revision
    This commit includes the final revisions Isaac will make on the Laser
    Board. Christian will be consulted before the board is manufactured.
    [laserboard.brd]
2016-02-07 Final motor controller
    This is the final layout of the motor controller board before
    manufacturing.
    [L6472V1.brd]
2016-02-09 Committing gerber files
    [L6472V1.GBL, L6472V1.GBO, L6472V1.GBS, L6472V1.GKO, L6472V1.GTL, L6472V1.GTO, L6472V1.GTS, L6472V1.XLN]
2016-02-11 Fixing schematics for design review, adding block diagram, upgrading version to prototype version 2
    [BlockDiagram.sch, L6472V1.sch, laserboard.sch]
2016-02-28 Fixing labeling on the uC board so that SPI is correct
    [uCBoard.brd, uCBoard.sch]
2016-02-28 Created New Footprints
    Footprints:
    JST
    BAC
    [L6472V1.sch]
2016-02-29 Fixing airwire on uCboard debug header
    [uCBoard.brd]
2016-03-01 Revision of Motorcontroller Board
    Footprints for the stepper motor connectors and BACs were replaced.
    [L6472V1.brd, L6472V1.sch]
2016-03-01 Updates to Laser and Power Board
    Updated emergency shutoff button footprint, led button voltage changed
    to 5v, and switched level shifter to 74LVC1T45.
    [L6472V1.brd, laserboard.brd, laserboard.sch]
2016-03-10 Final Revisions to PCBs and Schematics
    Final revisions made to the PCBs and schematics. This is the version
    which will be sent out to the board house for round two.
    [L6472V1.brd, laserboard.brd, laserboard.sch]
2016-03-12 Basic SPI Setup
    This is the first working spi setup. You can basically hardcode bytes to
    send over spi. More to come soon
2016-03-13 End of the night push
    This code adds some functionality to the L6472 library including reading
    and writing to the x and y devices. There is a bug when reading where
    bits are being doubled. Very stupid. I'm giving up for the night.
    [L6472.c, L6472.h, main.c]
2016-03-13 Fixed Bit Doubling Bug
    Fixed a bug with the incoming spi where bits were being counted double.
    Not entirely sure what fixed the issue but it is gone now so whatevs.
    [L6472.c, L6472.h, main.c]
2016-03-13 Added a few y axis functions
    Added functions for setting a few y axis parameters as well as run and
    move commands.
2016-03-16 Basic Y Busy Signal GPIO Setup
    The basic structure for reading the Y Busy signal has been setup. There
    is an issue with the GPIO pin pulling the Busy signal from the L6472
    low. Committing before I try changing to a different GPIO pin.
    [L6472.c, L6472.h, main.c]
2016-03-16 Messed around with motorcontroller and frame
2016-03-18 Laser Functions Work
    Functions for configuring and toggling a pin for control of the laser.
2016-03-18 Added y axis mm move function
    Added y_move_mm() which uses a float value of millimeters to define the stepper movements.
    For this to work, the spi_demo project floating point setting must be changed to "vfplib".
2016-03-19 Laser and Motor Libraries Pretty Much Done
    This includes most of the useful laser and motor control functions.
    L6472.h and LaserBoard.h should be added to your project along with
    their equivalent .c files. The y functions have been tested but the x
    have not.
2016-03-27 X and Y motor controllers working
    Basic x and y control established
2016-03-27 Laser and Motorcontrol GPIOs Configured
    The laser and motorcontrol gpios are configured and work correctly.
    [L6472.c, L6472.h, LaserBoard.c]
2016-03-29 Adding Final BOMS
    [LaserBoardBOM.xlsx, MotorBoardBOM.xlsx, OtherBOM.xlsx, laserboard_BOM.xlsx, uCBoardBOM.xlsx, uCBoard_BOM.xlsx]
2016-04-01 Move to Coordinate Added
    Added move_coord() which allows the motors to move to a specific
    coordinate in a straight line.
2016-04-02 File Operations
    Can save file from website and reopen it and is currently set to just
    print the lines back out on the screen
2016-04-02 Fixed xy_move_mm() bug
    xy_move_mm() was not executing moves when the x or y movement was zero.
    This was fixed by updating the control structure inside the function to
    include these cases.
    [L6472.c, main.c]
2016-04-02 Fixed move_coord() bug
    Fixed issue with diagonal moves with a side less than 0.1 mm. This is a
    crappy fix that ignores moves less than 0.1mm. This needs to be revised
    to prevent the accumulation of errors.
    [L6472.c, gcode.c, main.c]
2016-04-03 Edited arc functions
    Starting to include code to prevent skipping a full circle.
    [L6472.c, gcode.c, main.c]
2016-04-03 Fully operational now
    Code goes through the entirety of the flow needed to draw a design just
    need to correct how it divides the file for reading and also a way for
    it to go back to HttpServerTask
    [fileparse.obj, gpio_if.obj, main.obj, pinmux.obj, smartconfig.obj, startup_ccs.obj, uart_if.obj]
2016-04-03 Full project code
    Works for the most part, issue with circle etch
    [fileparse.c, main.c]
2016-04-04 Fixed Offset Issue in Arc Functions
    Amended the arc functions to properly use the I and J values as offsets
    from the starting point to find the center.
    [gcode.c, main.c]
2016-04-05 Tilt Sensor
    Added tilt sensor code to the project.
2016-04-24 Updating BOM to reflect new regulator
    [LaserBoardBOM.xlsx]
