crgonzalez/LaserCeeNC/(notices)

Notices in the files:
parts and their libraries:
COPYRIGHT: Copyright (C) 2015 Accelerated Designs. All rights reserved
SparkFun-Passives: Licensing: Creative Commons ShareAlike 4.0 International - https://creativecommons.org/licenses/by-sa/4.0
